morgensternR/Themometry_Enclosure/Thermometry_Enclosure/PCB_Assem.SLDASM

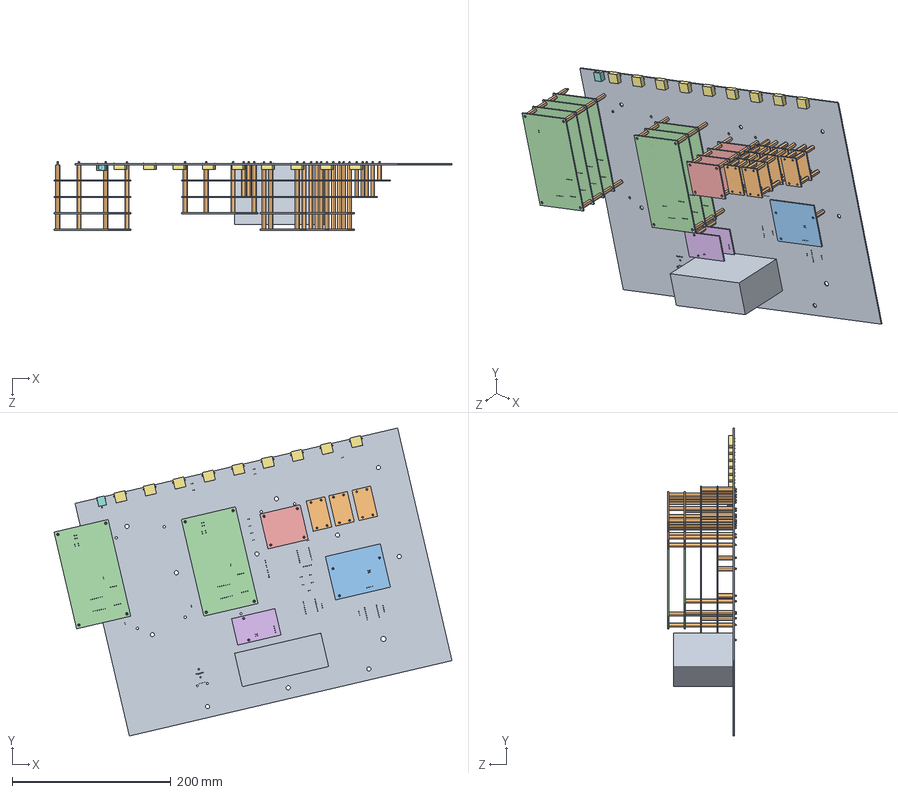
[picture p1: CAD file, 2025-06-28]
Thermometry_Enclosure/PCB_Assem.SLDASM
500.9 x 387.6 x 86.6 mm
Thermometry_Enclosure.step
Howland x 10
i2c_mux
sq_lockin_v6 x 7
hp_heater x 4
uart_mux x 2
hdmi_mockup x 9
DC_Power_Port
linux_pc
93505A215_Male-Female Threaded Hex Standoff x 91
