morgensternR/Themometry_Enclosure/Thermometry_Enclosure/Main.SLDASM

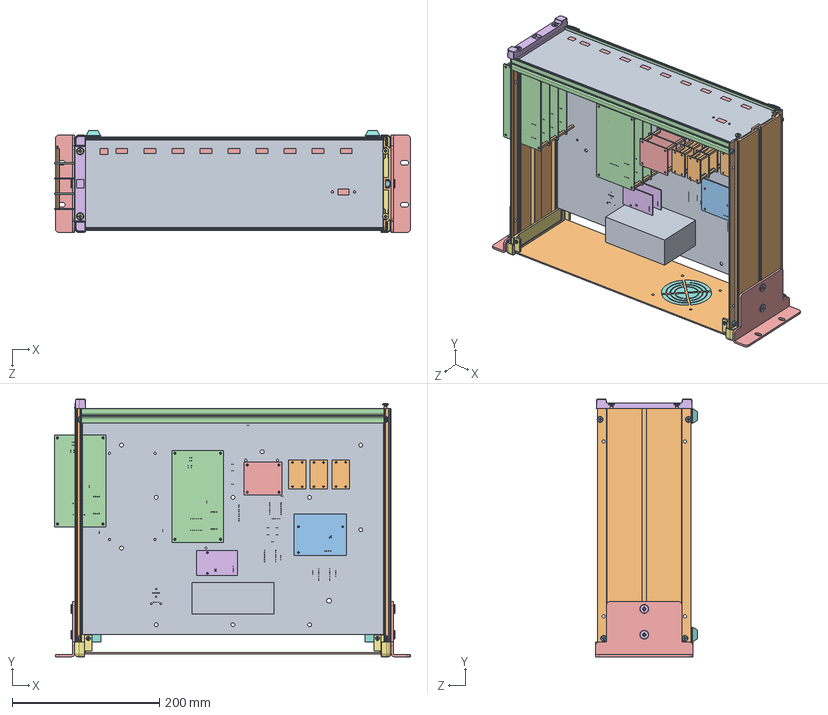
[picture p2: CAD file, 2023-06-21]
Thermometry_Enclosure/Main.SLDASM
483.8 x 350.0 x 138.6 mm
Thermometry_Enclosure.step
Howland x 10
i2c_mux
sq_lockin_v6 x 7
hp_heater x 4
uart_mux x 2
hdmi_mockup x 9
DC_Power_Port
linux_pc
93505A215_Male-Female Threaded Hex Standoff x 91
mz(ﾎﾙﾀﾞｰ).stp x 4
JIS B 1181 - A_B M5.stp x 4
msm-133_1.stp x 2
JIS B 1111 - M5x10.stp x 4
msk-133.stp x 2
JIS B 1111 (H) - M4x6 - CU2 - H.stp x 4
mss132.5-04.stp x 2
JIS B 1111 - A M4 x 8 - H.stp x 8
msf(rear)-06.stp x 2
JIS B 1111 - M4x10.stp x 4
ｺﾞﾑ足.stp x 4
Back_Panel
front_panel
