morgensternR/Themometry_Enclosure/Motherboard V2/back_panel.SLDPRT

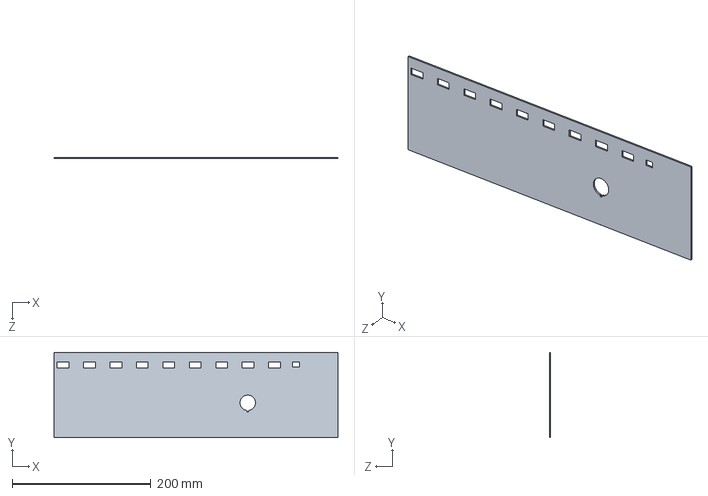
[picture p5: CAD file, 2025-06-28]
Motherboard V2/back_panel.SLDPRT
409.0 x 122.5 x 2.00 mm
