morgensternR/Themometry_Enclosure/Motherboard V2/Footprints & CAD/c-205869-1-ab-3d-50pin-Dsub.stp

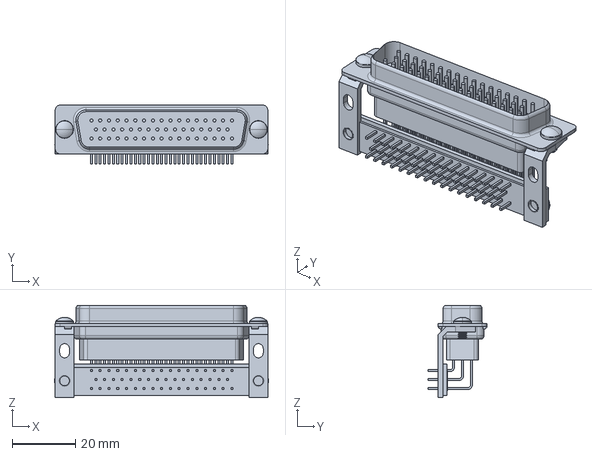
[picture p6: CAD file, 2025-04-04]
Motherboard V2/Footprints & CAD/c-205869-1-ab-3d-50pin-Dsub.stp
67.5 x 18.6 x 29.1 mm
