morgensternR/Themometry_Enclosure/Motherboard V2/Footprints & CAD/CAD/DC-IN-TH_DC-044K-D025.step

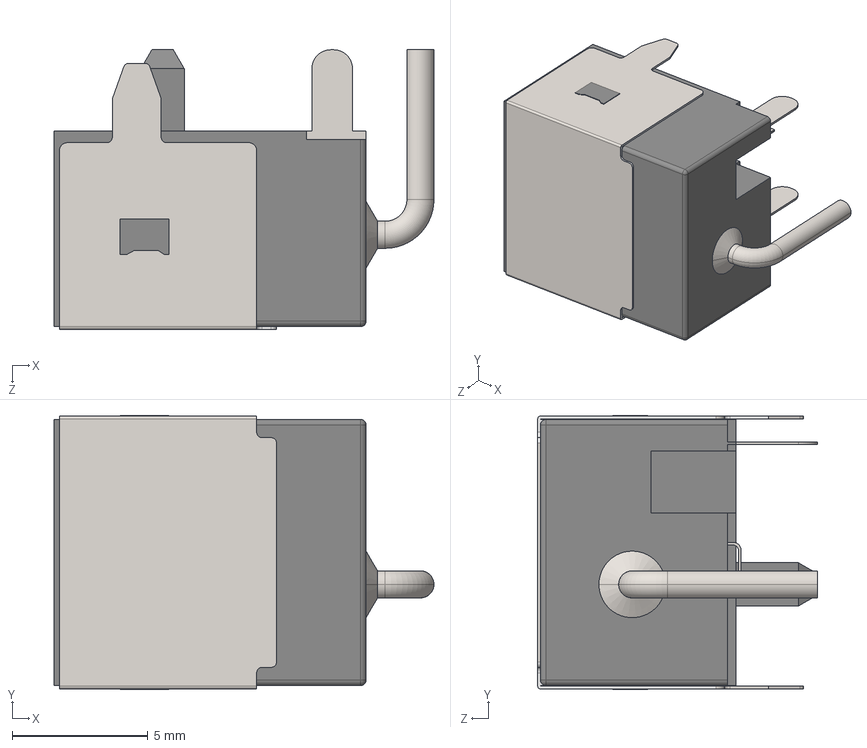
[picture p7: CAD file, 2025-05-05]
Motherboard V2/Footprints & CAD/CAD/DC-IN-TH_DC-044K-D025.step
14.0 x 10.1 x 10.3 mm
