morgensternR/Themometry_Enclosure/support_peg.SLDPRT

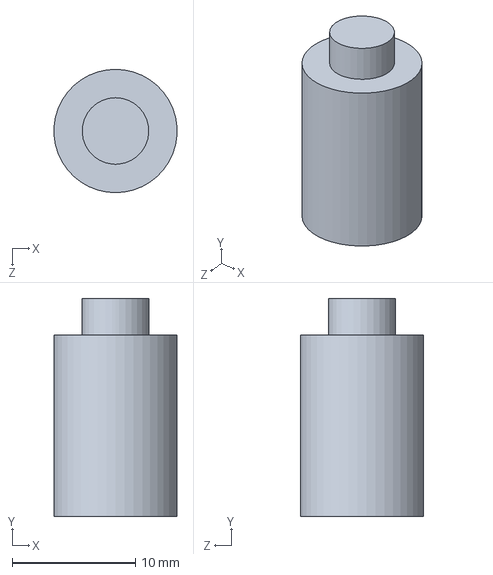
[picture p8: CAD file, 2023-06-21]
support_peg.SLDPRT
9.97 x 17.7 x 10.0 mm
