morgensternR/Themometry_Enclosure/Motherboard V2/Footprints & CAD/CAD/HDMI_RG9922-111D20-01B0.stp

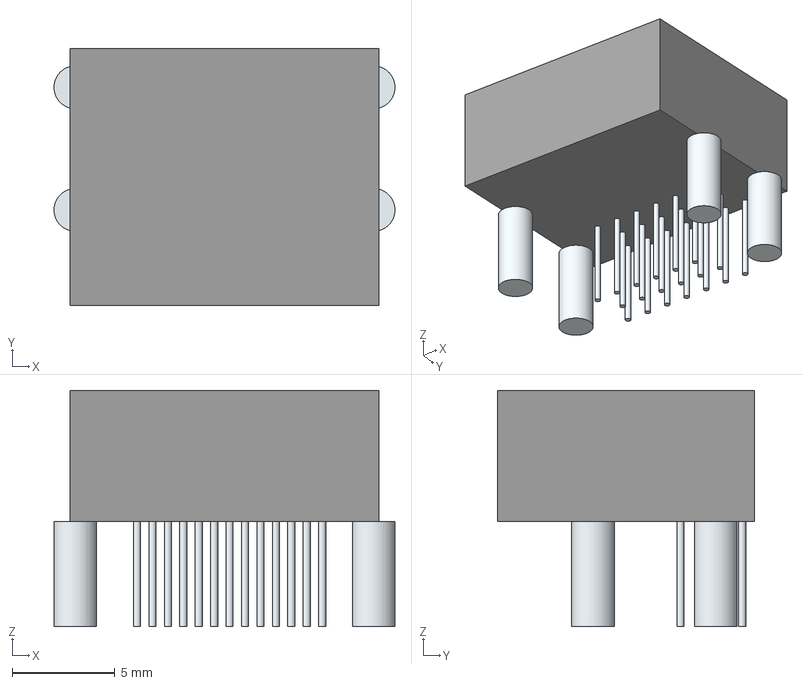
[picture p9: CAD file, 2025-05-05]
Motherboard V2/Footprints & CAD/CAD/HDMI_RG9922-111D20-01B0.stp
16.6 x 12.5 x 11.5 mm
Leads
