morgensternR/Themometry_Enclosure/Motherboard V2/support_peg.SLDPRT

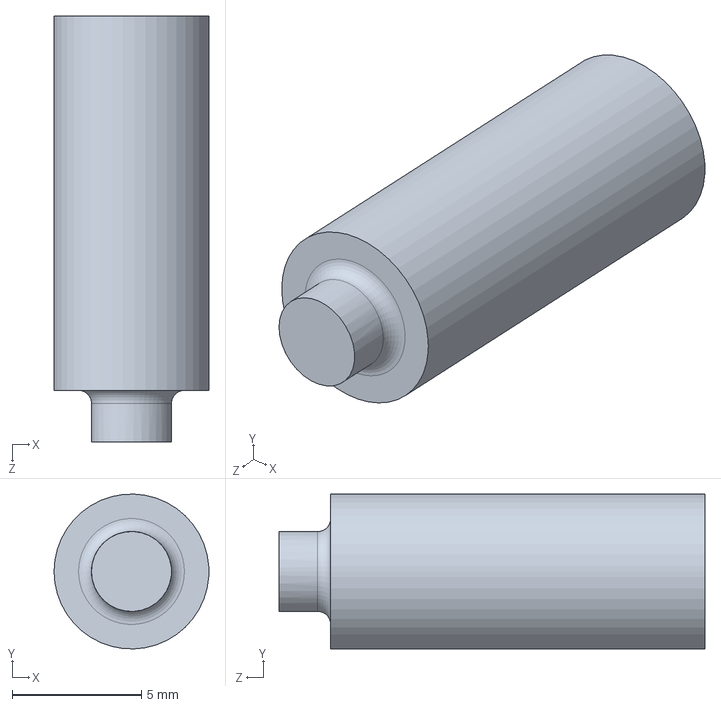
[picture p10: CAD file, 2025-06-28]
Motherboard V2/support_peg.SLDPRT
6.00 x 6.00 x 16.5 mm
