morgensternR/Themometry_Enclosure/Motherboard V2/Footprints & CAD/CAD/CONN-TH_436500215.step

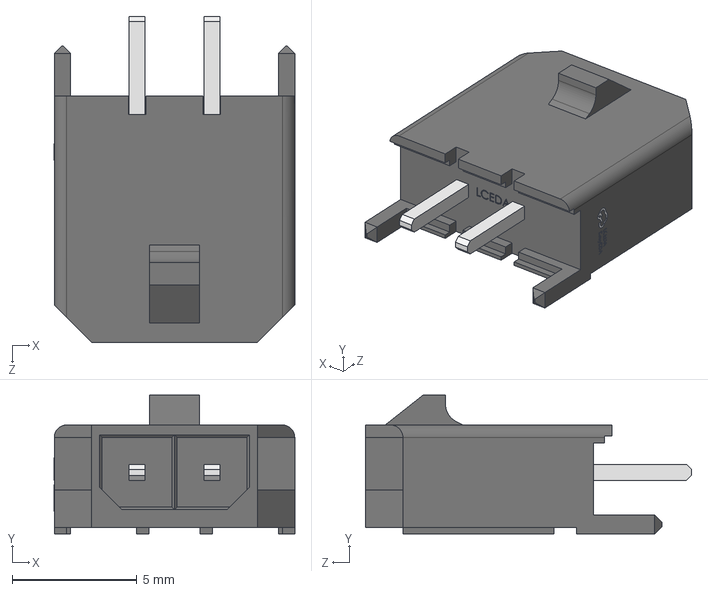
[picture p11: CAD file, 2025-04-04]
Motherboard V2/Footprints & CAD/CAD/CONN-TH_436500215.step
9.65 x 5.57 x 13.1 mm
