morgensternR/Themometry_Enclosure/Motherboard V2/motherboard_v1.step

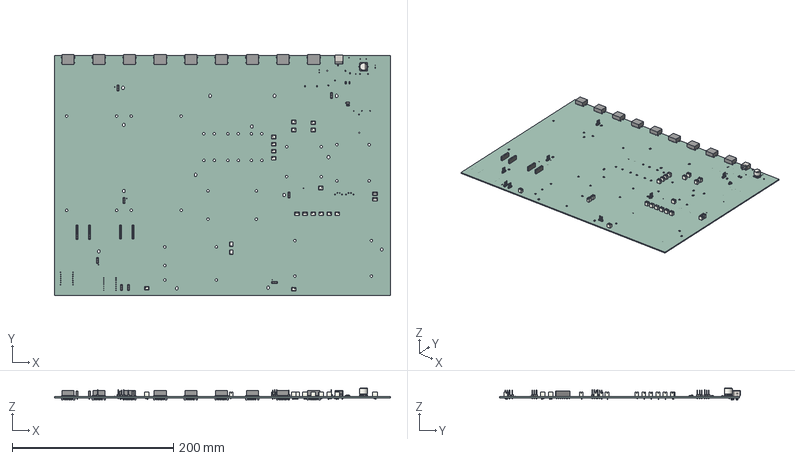
[picture p12: CAD file, 2025-06-28]
Motherboard V2/motherboard_v1.step
417.0 x 299.6 x 14.5 mm
C_1206_3216Metric x 3
R_0402_1005Metric x 3
ASSEMBLY x 9
JST_B2B_PH_K x 21
C_0402_1005Metric x 6
PinSocket_1x07_P254mm_Vertical x 4
PinHeader_1x03_P254mm_Vertical x 8
DC-IN-TH_DC-044K-D025
D_SMA
C_0603_1608Metric x 2
LED_0603_1608Metric x 2
CP_Elec_10x105
motherboard_v1_PCB
