morgensternR/Themometry_Enclosure/Thermometry_Enclosure/hdmi_mockup.SLDPRT

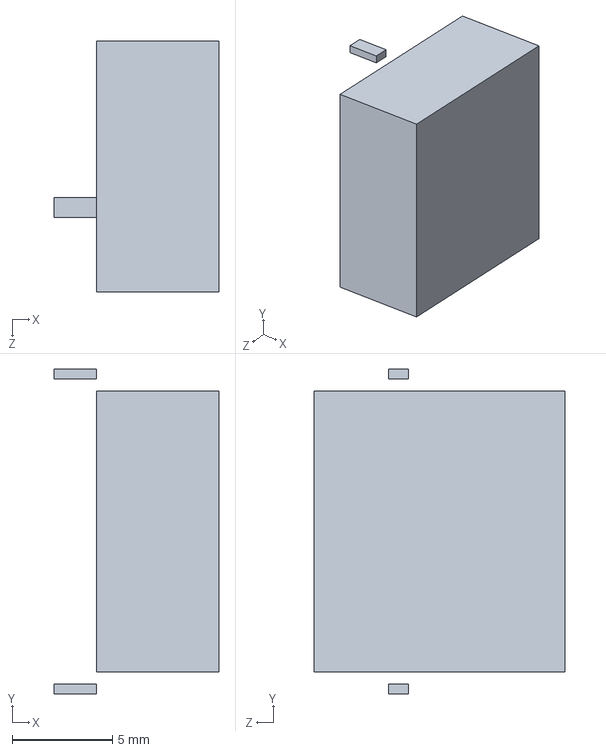
[picture p13: CAD file, 2025-06-28]
Thermometry_Enclosure/hdmi_mockup.SLDPRT
8.20 x 16.2 x 12.5 mm
