morgensternR/Themometry_Enclosure/Motherboard V2/Footprints & CAD/CAD/FUSE-SMD_L6.1-W2.7-H2.7.step

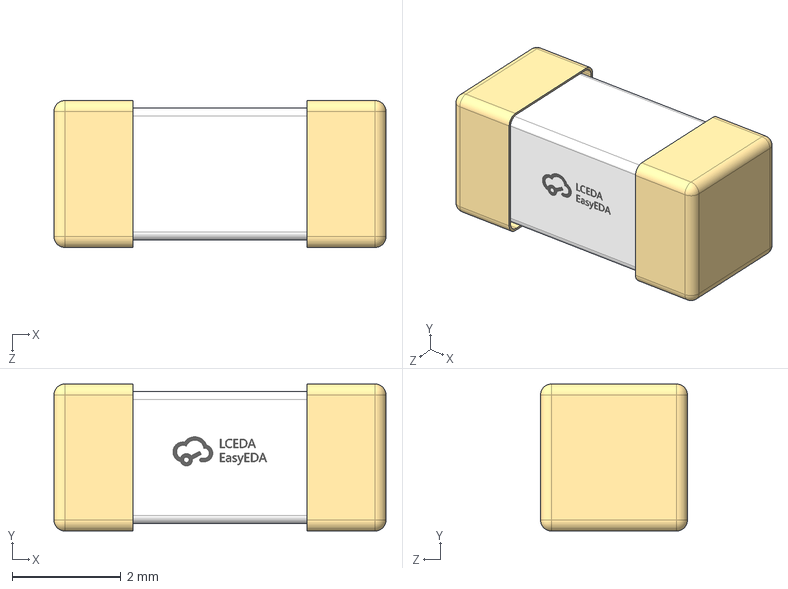
[picture p14: CAD file, 2025-04-04]
Motherboard V2/Footprints & CAD/CAD/FUSE-SMD_L6.1-W2.7-H2.7.step
6.10 x 2.70 x 2.70 mm
