morgensternR/Themometry_Enclosure/Thermometry_Enclosure/DC_Power_Port.SLDPRT

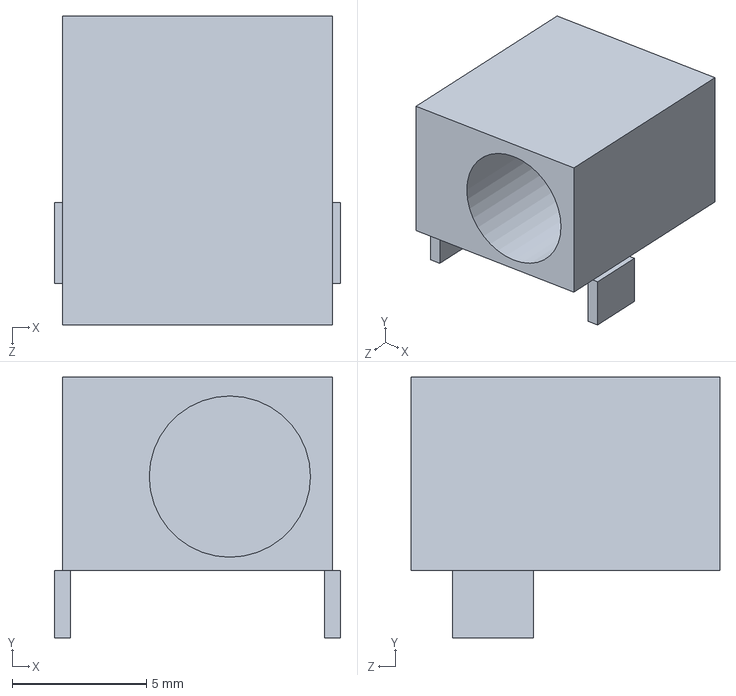
[picture p15: CAD file, 2025-06-28]
Thermometry_Enclosure/DC_Power_Port.SLDPRT
10.6 x 9.70 x 11.5 mm
