morgensternR/Themometry_Enclosure/Motherboard V2/Footprints & CAD/CAD/i2c_mux.step

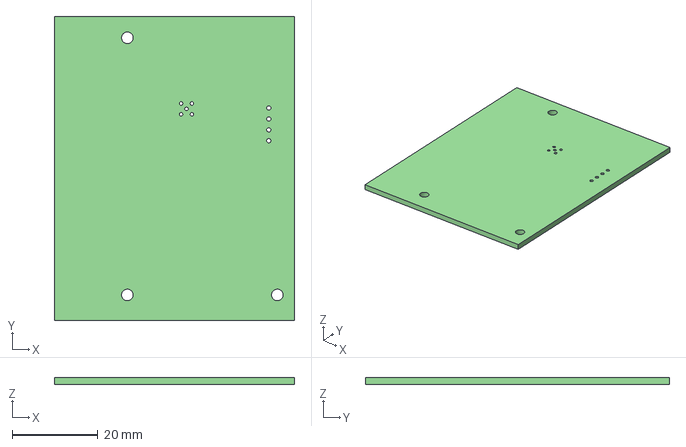
[picture p16: CAD file, 2025-04-04]
Motherboard V2/Footprints & CAD/CAD/i2c_mux.step
56.0 x 71.0 x 1.60 mm
