morgensternR/Themometry_Enclosure/Motherboard V2/input_power_connector_436500427.stp

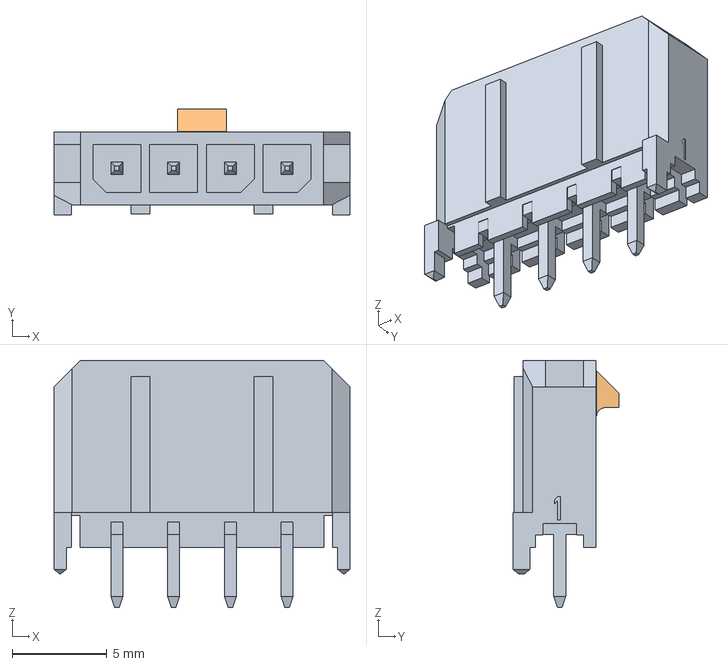
[picture p17: CAD file, 2025-04-04]
Motherboard V2/input_power_connector_436500427.stp
15.7 x 5.61 x 13.1 mm
