morgensternR/Themometry_Enclosure/Motherboard V2/BM04B-SRSS-TB.STEP

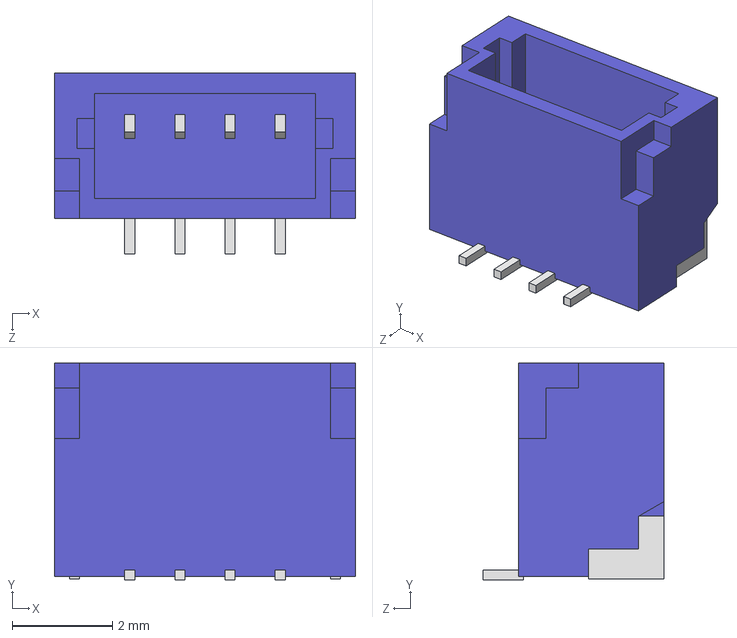
[picture p18: CAD file, 2025-04-04]
Motherboard V2/BM04B-SRSS-TB.STEP
6.00 x 4.32 x 3.60 mm
