morgensternR/Themometry_Enclosure/Thermometry_Enclosure/sq_lockin_v6.SLDPRT

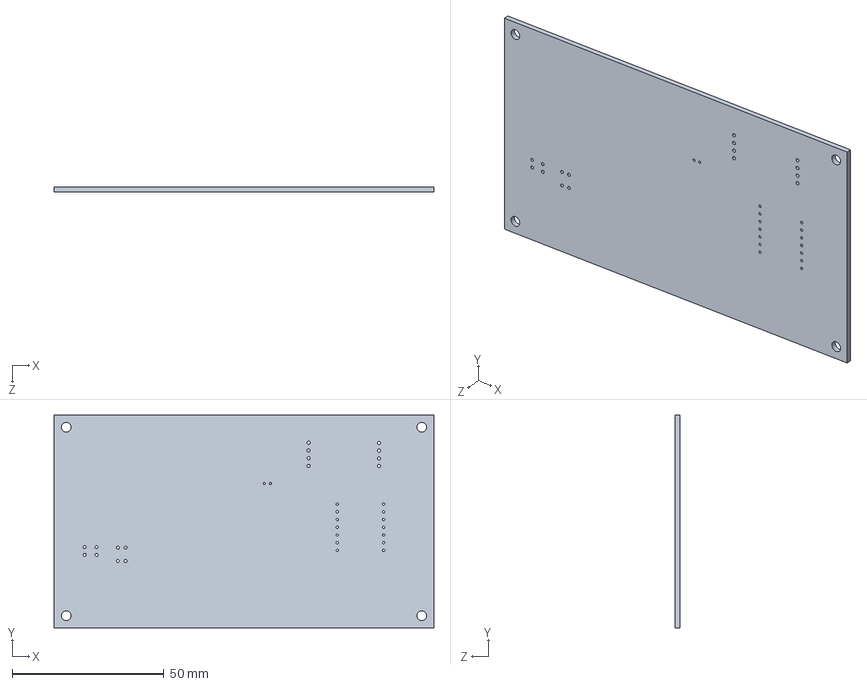
[picture p19: CAD file, 2025-06-28]
Thermometry_Enclosure/sq_lockin_v6.SLDPRT
125.0 x 70.0 x 1.60 mm
