morgensternR/Themometry_Enclosure/Thermometry_Enclosure/uart_mux.SLDPRT

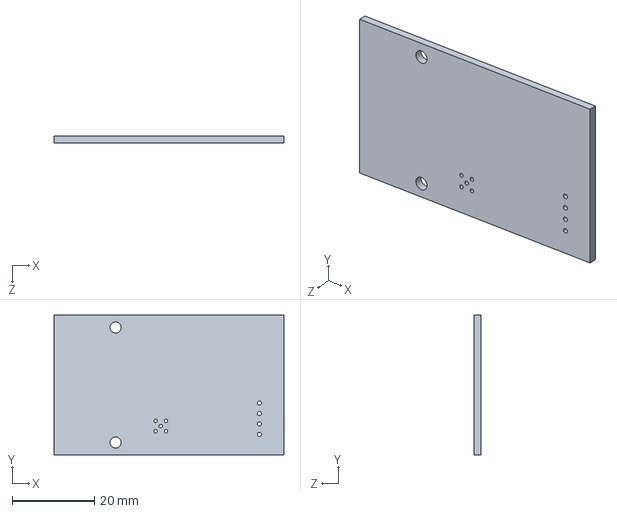
[picture p20: CAD file, 2025-06-28]
Thermometry_Enclosure/uart_mux.SLDPRT
56.0 x 34.0 x 1.60 mm
