morgensternR/Themometry_Enclosure/Thermometry_Enclosure/Thermometry_Enclosure.step.SLDPRT

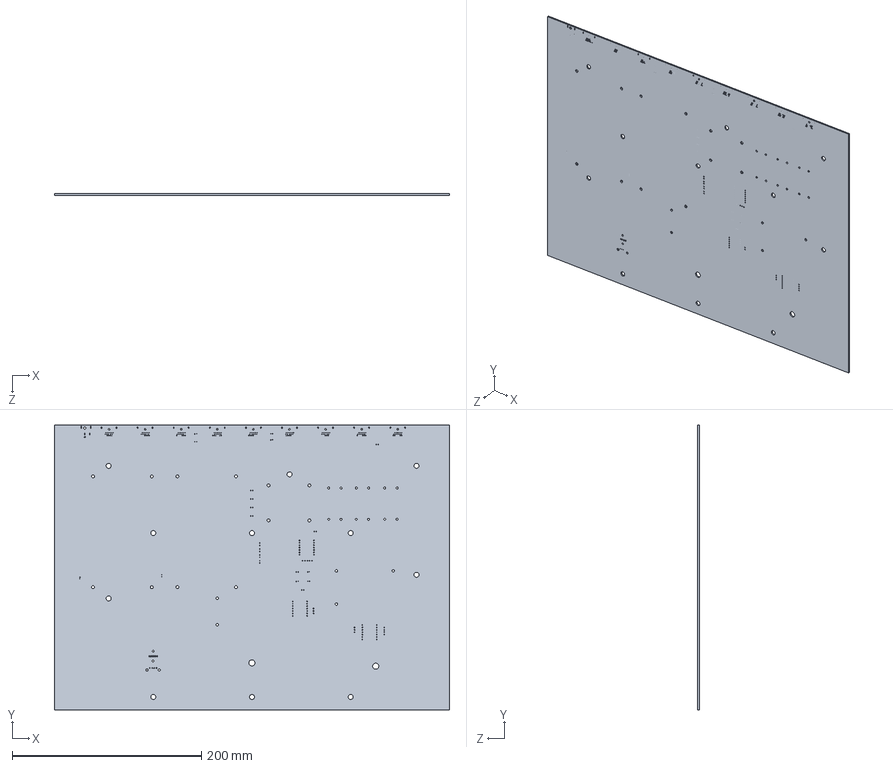
[picture p21: CAD file, 2025-06-28]
Thermometry_Enclosure/Thermometry_Enclosure.step.SLDPRT
417.0 x 300.6 x 1.60 mm
