morgensternR/Themometry_Enclosure/Thermometry_Enclosure/hp_heater.SLDPRT

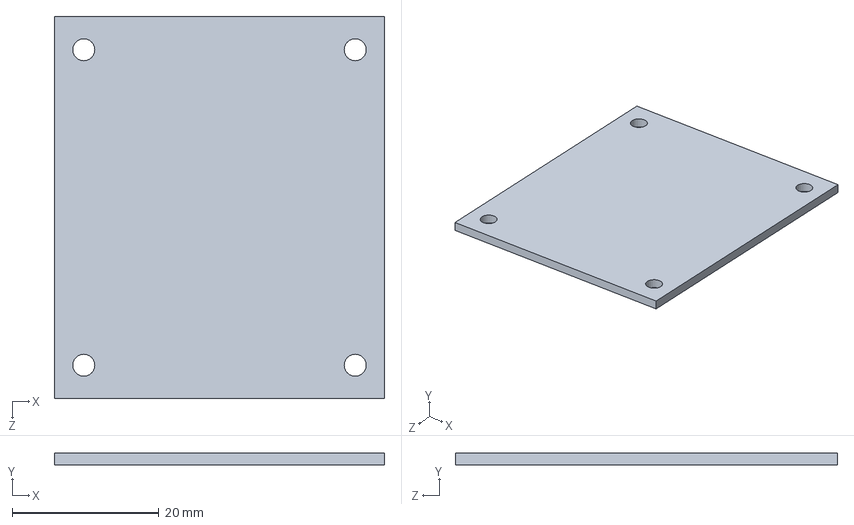
[picture p22: CAD file, 2025-06-28]
Thermometry_Enclosure/hp_heater.SLDPRT
45.0 x 1.60 x 52.1 mm
