morgensternR/Themometry_Enclosure/Thermometry_Enclosure/Howland.SLDPRT

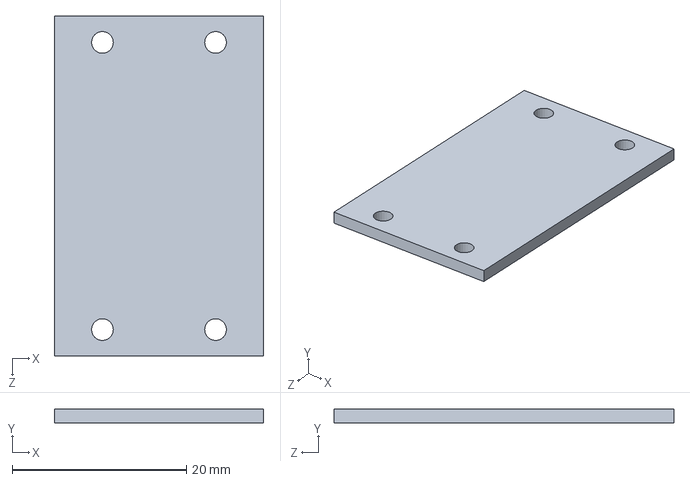
[picture p23: CAD file, 2025-06-28]
Thermometry_Enclosure/Howland.SLDPRT
24.0 x 1.60 x 39.1 mm
