morgensternR/Themometry_Enclosure/Thermometry_Enclosure/linux_pc.SLDPRT

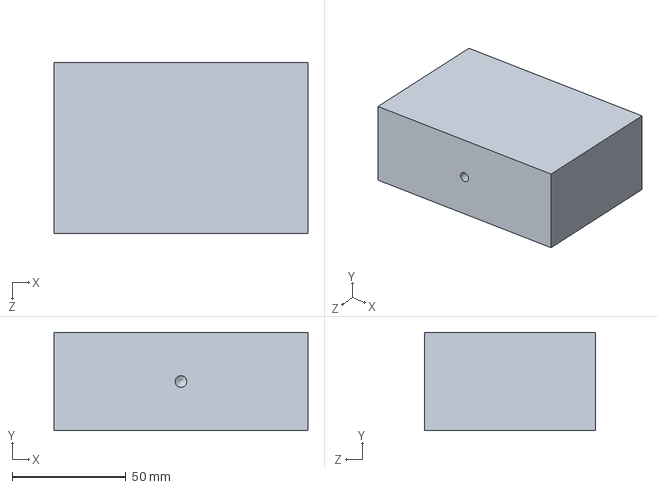
[picture p24: CAD file, 2025-06-28]
Thermometry_Enclosure/linux_pc.SLDPRT
111.5 x 43.2 x 75.0 mm
