morgensternR/Themometry_Enclosure/Motherboard V2/Main.SLDASM

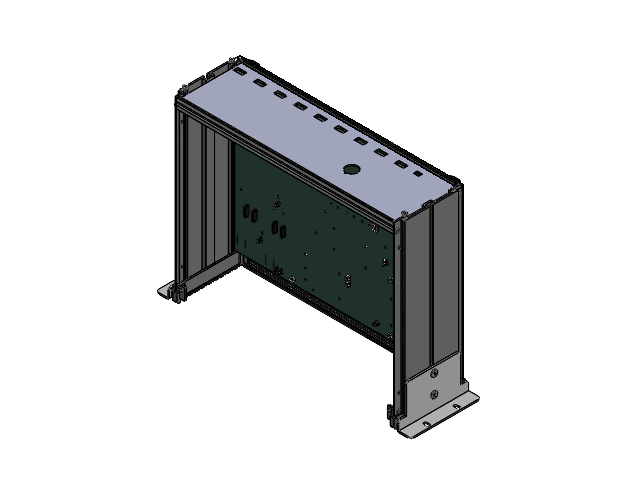
[picture p25: CAD file, 2025-06-28]
Motherboard V2/Main.SLDASM
mz(ﾎﾙﾀﾞｰ).stp x 4
JIS B 1181 - A_B M5.stp x 4
msm-133_1.stp x 2
JIS B 1111 - M5x10.stp x 4
msff-06.stp
msk-133.stp x 2
JIS B 1111 (H) - M4x6 - CU2 - H.stp x 4
mss132.5-04.stp x 2
JIS B 1111 - A M4 x 8 - H.stp x 8
msf(rear)-06.stp x 2
mot-21.stp
JIS B 1111 - M4x10.stp x 3
ｺﾞﾑ足.stp x 4
C_1206_3216Metric-0.step x 3
R_0402_1005Metric-1.step x 3
ASSEMBLY.step x 9
JST_B2B_PH_K.step x 21
C_0402_1005Metric-2.step x 6
PinSocket_1x07_P254mm_Vertical.step x 4
PinHeader_1x03_P254mm_Vertical.step x 8
DC-IN-TH_DC-044K-D025-3.step
D_SMA-4.step
C_0603_1608Metric-5.step x 2
LED_0603_1608Metric-6.step x 2
CP_Elec_10x105.step
motherboard_v1_PCB.step
front_panel
