morgensternR/Themometry_Enclosure/(list of files, cad)

Other CAD files:
Thermometry_Enclosure/front_panel.SLDPRT
Thermometry_Enclosure/Parts/MOR133-43-35□.stp
Thermometry_Enclosure/Back_Panel.SLDPRT
Thermometry_Enclosure/i2c_mux.SLDPRT
Thermometry_Enclosure/Thermometry_Enclosure.step
Thermometry_Enclosure/Back_Panel.DXF
Thermometry_Enclosure/Parts/93505A105_Male-Female Threaded Hex Standoff.SLDPRT
Thermometry_Enclosure/Parts/93505A215_Male-Female Threaded Hex Standoff.SLDPRT
Thermometry_Enclosure/front_panel.DXF
support_peg.STL
