morgensternR/Themometry_Enclosure/Motherboard V2/motherboard_v1.kicad_pcb

## KiCad design Motherboard V2/motherboard_v1.kicad_pcb (2025-04-04)

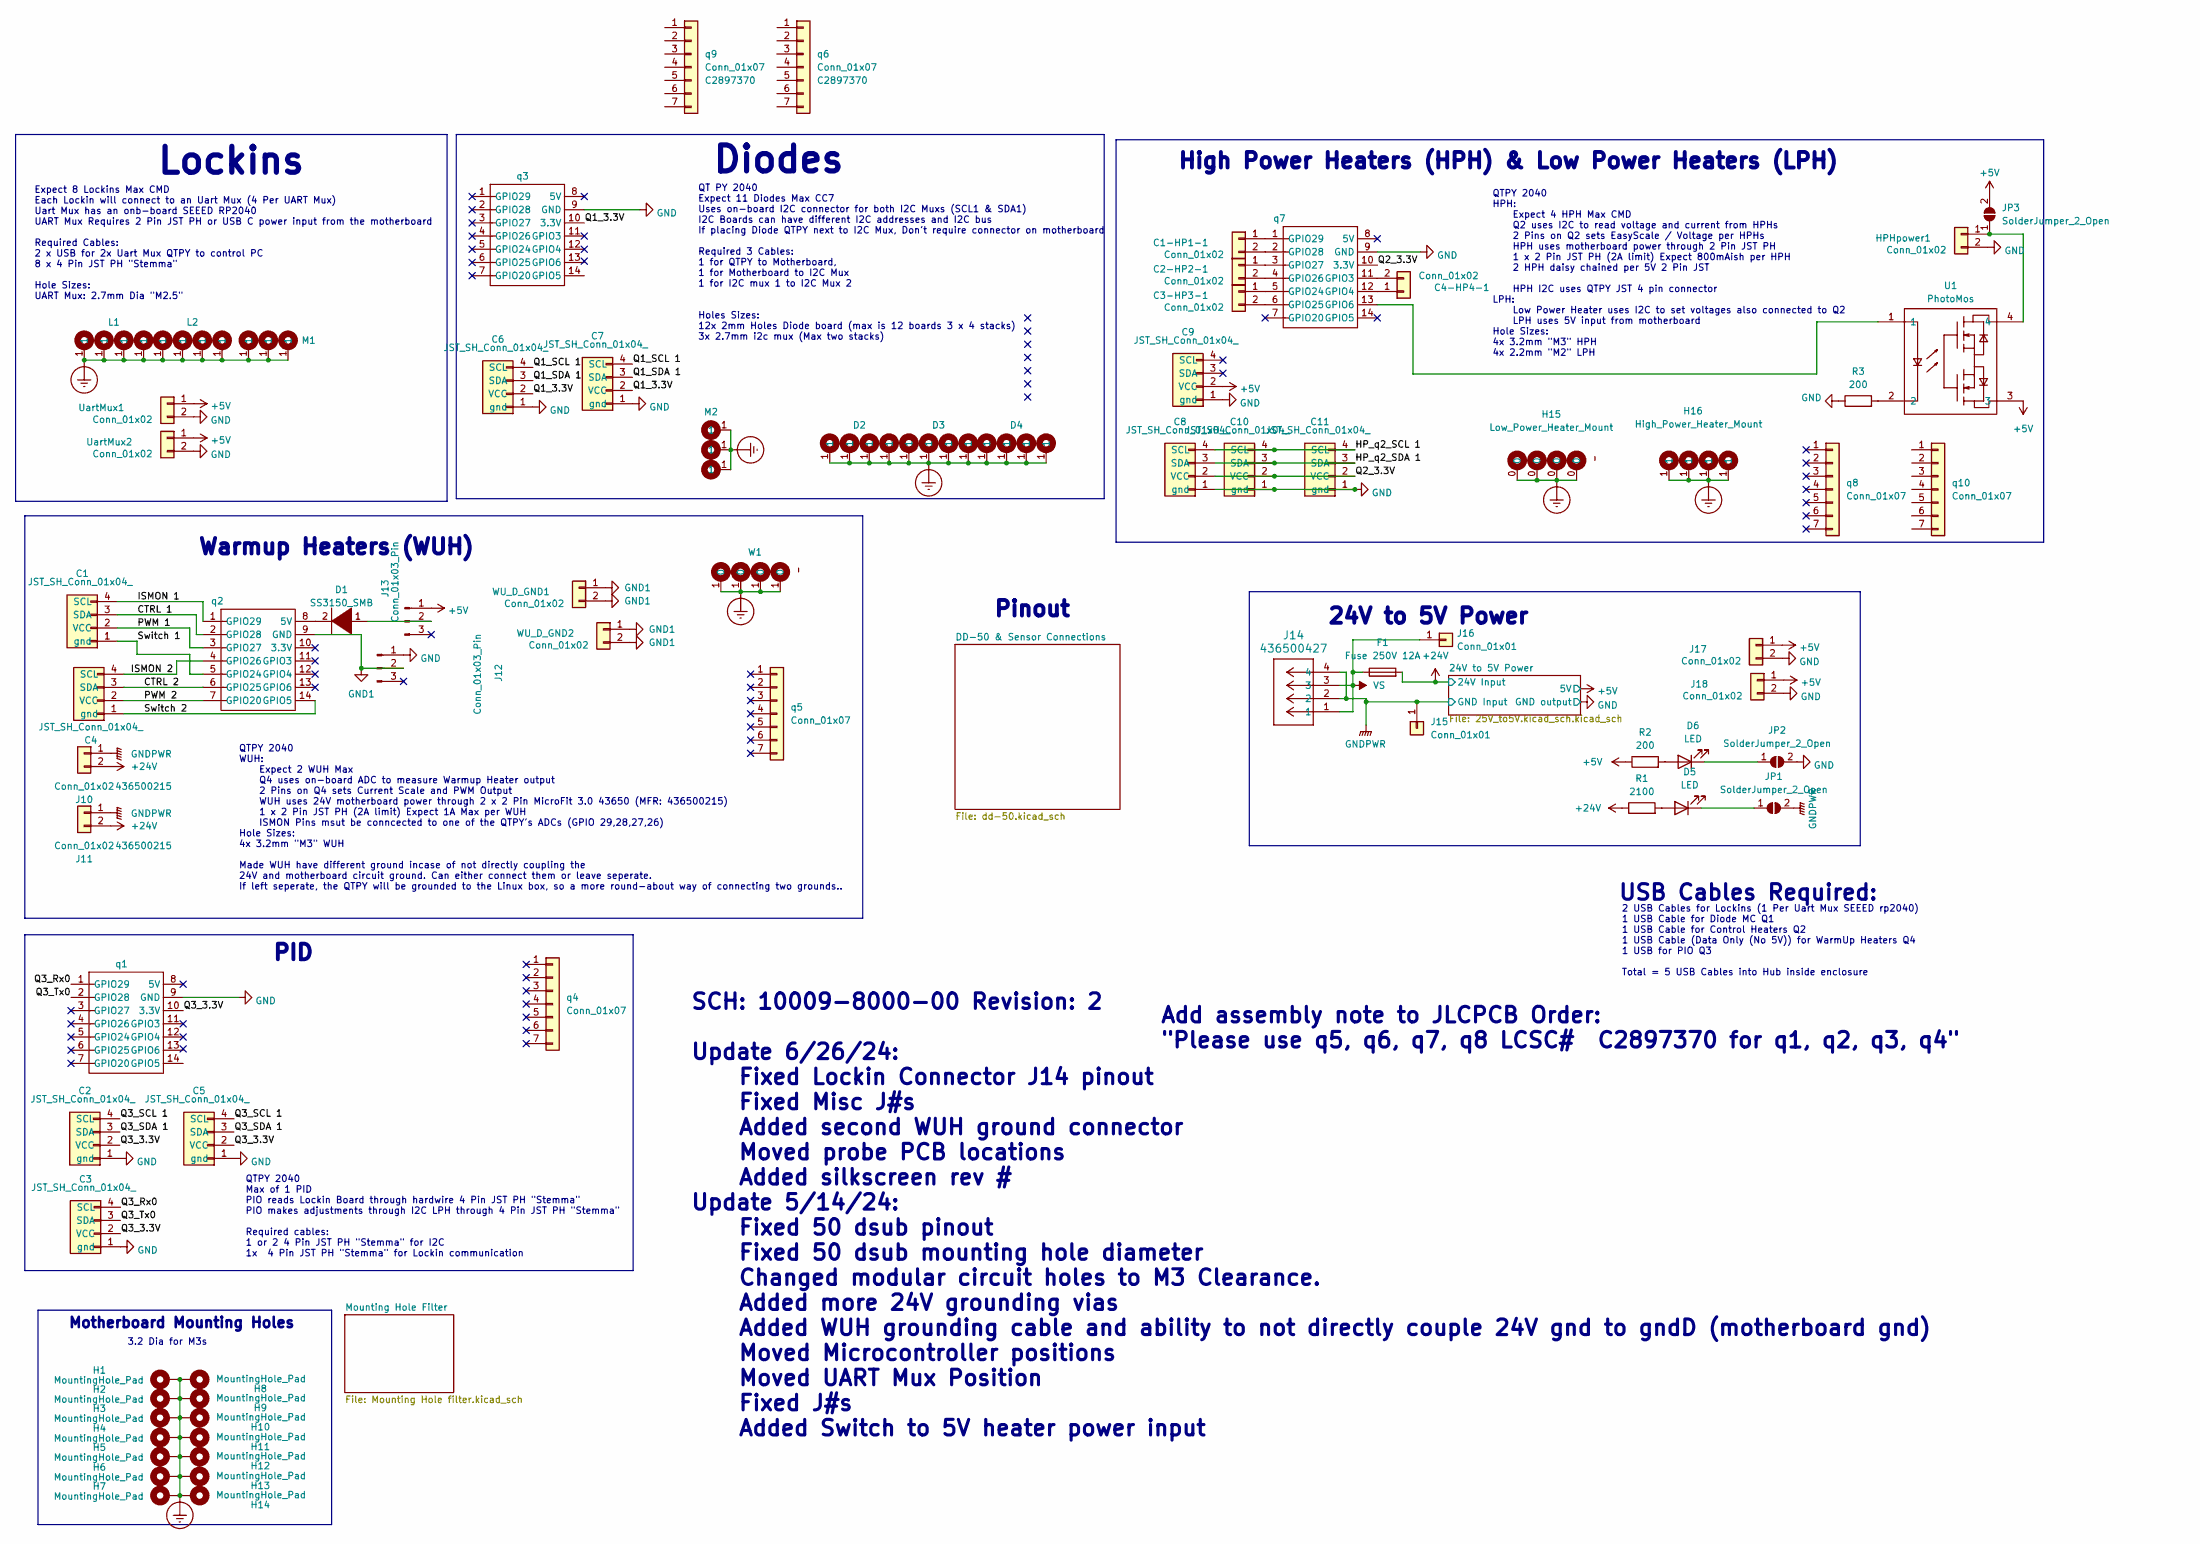
[picture p26: schematic motherboard_v1.kicad_sch]

Parts:
C1, C2, C3, C4, C5, C6, C7, C8, C9, C10, C11: JST_SH_Conn_01x04_; JST_SH_BM04B-SRSS-TB_1x04-1MP_P1.00mm_Vertical; MPN A1001WR-S; LCSC C160390
C1-HP1-1, C2-HP2-1, C3-HP3-1, C4-HP4-1: Conn_01x02; JST_PH_B2B-PH-K_1x02_P2.00mm_Vertical; LCSC C2683610
D1: SS3150_SMB; SMB_L4.6-W3.6-LS5.3-RD; LCSC C47124
D2, D3, D4: Diode_Board
D5, D6: LED; LED_0603_1608Metric_Pad1.05x0.95mm_HandSolder; LCSC C965804
F1: Fuse 250V 12A; Fuse_holder; LCSC C268204
H1, H2, H3, H4, H5, H6, H7, H8, H9, H10, H11, H12, H13, H14: MountingHole_Pad; Slot_Mounting_Hole
H15: Low_Power_Heater_Mount; Low_Power_Heater_Board
H16: High_Power_Heater_Mount; HPH_Board
HPHpower1: Conn_01x02; JST_PH_B2B-PH-K_1x02_P2.00mm_Vertical; LCSC C2683610
J10, J11: Conn_01x02; CONN-TH_436500215; LCSC C293740
J12, J13: Conn_01x03_Pin; PinHeader_1x03_P2.54mm_Vertical; LCSC C2937625
J14: 436500427; CON_436500427_MOL
J15: Conn_01x01; Test_Point_TH_BD3.2-D2.0; LCSC C5199811
J16: Conn_01x01; Test_Point_TH_BD3.2-D2.0; LCSC C5277086
J17, J18: Conn_01x02; JST_PH_B2B-PH-K_1x02_P2.00mm_Vertical; LCSC C2683610
JP1, JP2, JP3: SolderJumper_2_Open; SolderJumper-2_P1.3mm_Open_RoundedPad1.0x1.5mm
L1, L2: Lockin_board
M1: Uart Mux
M2: i2c_Mux
R1: 2100; R_0402_1005Metric; LCSC C2998067
R2, R3: 200; R_0402_1005Metric; LCSC C25087
U1: PhotoMos; HPH_Switch_SOP-4_L4.4-W4.3-P2.54-LS6.8-BL; LCSC C2691608
UartMux1, UartMux2: Conn_01x02; JST_PH_B2B-PH-K_1x02_P2.00mm_Vertical; LCSC C2683610
W1: Warmup circuit
WU_D_GND1, WU_D_GND2: Conn_01x02; JST_PH_B2B-PH-K_1x02_P2.00mm_Vertical; LCSC C2683610
q1, q2, q3, q7: Microcontroller-qtpy; LCSC C2897370
q4, q5, q6, q8, q9, q10: Conn_01x07; PinSocket_1x07_P2.54mm_Vertical; LCSC C2897370

Connections:
+5V: C9.2 (VCC), J13.1, J17.1, J18.1, JP3.2 (B), R2.1, U1.3, UartMux1.1, UartMux2.1; also elsewhere on the board
+24V: F1.2, J10.2, J11.2, R1.1; also elsewhere on the board
/CTRL 1: C1.3 (SDA), q2.2 (GPIO28)
/CTRL 2: C4.3 (SDA), q2.6 (GPIO25)
/HP_q2_SCL 1: C8.4 (SCL), C10.4 (SCL), C11.4 (SCL)
/HP_q2_SDA 1: C8.3 (SDA), C10.3 (SDA), C11.3 (SDA)
/ISMON 1: C1.4 (SCL), q2.1 (GPIO29)
/ISMON 2: C4.4 (SCL), q2.4 (GPIO26)
/PWM 1: C1.2 (VCC), q2.3 (GPIO27)
/PWM 2: C4.2 (VCC), q2.7 (GPIO20)
/Q1_3.3V: C6.2 (VCC), C7.2 (VCC), q3.10 (3.3V)
/Q1_SCL 1: C6.4 (SCL), C7.4 (SCL)
/Q1_SDA 1: C6.3 (SDA), C7.3 (SDA)
/Q2_3.3V: C8.2 (VCC), C10.2 (VCC), C11.2 (VCC), q7.10 (3.3V)
/Q3_3.3V: C2.2 (VCC), C3.2 (VCC), C5.2 (VCC), q1.10 (3.3V)
/Q3_Rx0: C3.4 (SCL), q1.1 (GPIO29)
/Q3_SCL 1: C2.4 (SCL), C5.4 (SCL)
/Q3_SDA 1: C2.3 (SDA), C5.3 (SDA)
/Q3_Tx0: C3.3 (SDA), q1.2 (GPIO28)
/Switch 1: C1.1 (gnd), q2.5 (GPIO24)
/Switch 2: C4.1 (gnd), q2.14 (GPIO5)
Earth_Protective: D2.1, D3.1, D4.1, H1.1, H2.1, H3.1, H4.1, H5.1, H6.1, H7.1, H8.1, H9.1, H10.1, H11.1, H12.1, H13.1, H14.1, H15.0, H16.1, L1.1, L2.1, M1.1, M2.1, W1.1 (0); also elsewhere on the board
GND: C2.1 (gnd), C3.1 (gnd), C5.1 (gnd), C6.1 (gnd), C7.1 (gnd), C8.1 (gnd), C9.1 (gnd), C10.1 (gnd), C11.1 (gnd), HPHpower1.2, J12.1, J17.2, J18.2, JP2.2 (B), R3.1, UartMux1.2, UartMux2.2, q1.9 (GND), q3.9 (GND), q7.9 (GND); also elsewhere on the board
GND1: J12.2, WU_D_GND1.1, WU_D_GND1.2, WU_D_GND2.1, WU_D_GND2.2, q2.9 (GND)
GNDPWR: J10.1, J11.1, J14.2, J14.4, J15.1, JP1.2 (B); also elsewhere on the board
unnamed: C1-HP1-1.1, q7.1 (GPIO29)
unnamed: C1-HP1-1.2, q7.2 (GPIO28)
unnamed: C2-HP2-1.1, q7.3 (GPIO27)
unnamed: C2-HP2-1.2, q7.4 (GPIO26)
unnamed: C3-HP3-1.1, q7.5 (GPIO24)
unnamed: C3-HP3-1.2, q7.6 (GPIO25)
unnamed: C4-HP4-1.1, q7.12 (GPIO4)
unnamed: C4-HP4-1.2, q7.11 (GPIO3)
unnamed: D1.2 (A), q2.8 (5V)
unnamed: D1.1 (K), J13.2
unnamed: D5.2 (A), R1.2
unnamed: D5.1 (K), JP1.1 (A)
unnamed: D6.2 (A), R2.2
unnamed: D6.1 (K), JP2.1 (A)
unnamed: HPHpower1.1, JP3.1 (A), U1.4
unnamed: R3.2, U1.2
unnamed: U1.1, q7.13 (GPIO6)
VS: F1.1, J14.1, J14.3, J16.1

Notes on the sheet:
High Power Heaters (HPH) & Low Power Heaters (LPH)
24V to 5V Power
QT PY 2040 Expect 11 Diodes Max CC7 Uses on-board I2C connector for both I2C Muxs (SCL1 & SDA1) I2C Boards can have different I2C addresses and I2C bus If placing Diode QTPY next to I2C Mux, Don't require connector on motherboard Required 3 Cables: 1 for QTPY to Motherboard, 1 for Motherboard to I2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
Diodes
Lockins
Expect 8 Lockins Max CMD Each Lockin will connect to an Uart Mux (4 Per UART Mux) Uart Mux has an onb-board SEEED RP2040 UART Mux Requires 2 Pin JST PH or USB C power input from the motherboard Required Cables: 2 x USB for 2x Uart Mux QTPY to control PC 8 x 4 Pin JST PH "Stemma" Hole Sizes: UART Mu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
Warmup Heaters (WUH)
QTPY 2040 HPH: Expect 4 HPH Max CMD Q2 uses I2C to read voltage and current from HPHs 2 Pins on Q2 sets EasyScale / Voltage per HPHs HPH uses motherboard power through 2 Pin JST PH 1 x 2 Pin JST PH (2A limit) Expect 800mAish per HPH 2 HPH daisy chained per 5V 2 Pin JST HPH I2C uses QTPY JST 4 pin c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
Pinout
PID
QTPY 2040 Max of 1 PID PIO reads Lockin Board through hardwire 4 Pin JST PH "Stemma" PIO makes adjustments through I2C LPH through 4 Pin JST PH "Stemma" Required cables: 1 or 2 4 Pin JST PH "Stemma" for I2C 1x 4 Pin JST PH "Stemma" for Lockin communication
USB Cables Required:
Motherboard Mounting Holes
Add assembly note to JLCPCB Order: "Please use q5, q6, q7, q8 LCSC# C2897370 for q1, q2, q3, q4"
SCH: 10009-8000-00 Revision: 2 Update 6/26/24: Fixed Lockin Connector J14 pinout Fixed Misc J#s Added second WUH ground connector Moved probe PCB locations Added silkscreen rev # Update 5/14/24: Fixed 50 dsub pinout Fixed 50 dsub mounting hole diameter Changed modular circuit holes to M3 Clearance.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
QTPY 2040 WUH: Expect 2 WUH Max Q4 uses on-board ADC to measure Warmup Heater output 2 Pins on Q4 sets Current Scale and PWM Output WUH uses 24V motherboard power through 2 x 2 Pin MicroFit 3.0 43650 (MFR: 436500215) 1 x 2 Pin JST PH (2A limit) Expect 1A Max per WUH ISMON Pins msut be conncected to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
3.2 Dia for M3s
2 USB Cables for Lockins (1 Per Uart Mux SEEED rp2040) 1 USB Cable for Diode MC Q1 1 USB Cable for Control Heaters Q2 1 USB Cable (Data Only (No 5V)) for WarmUp Heaters Q4 1 USB for PIO Q3 Total = 5 USB Cables into Hub inside enclosure

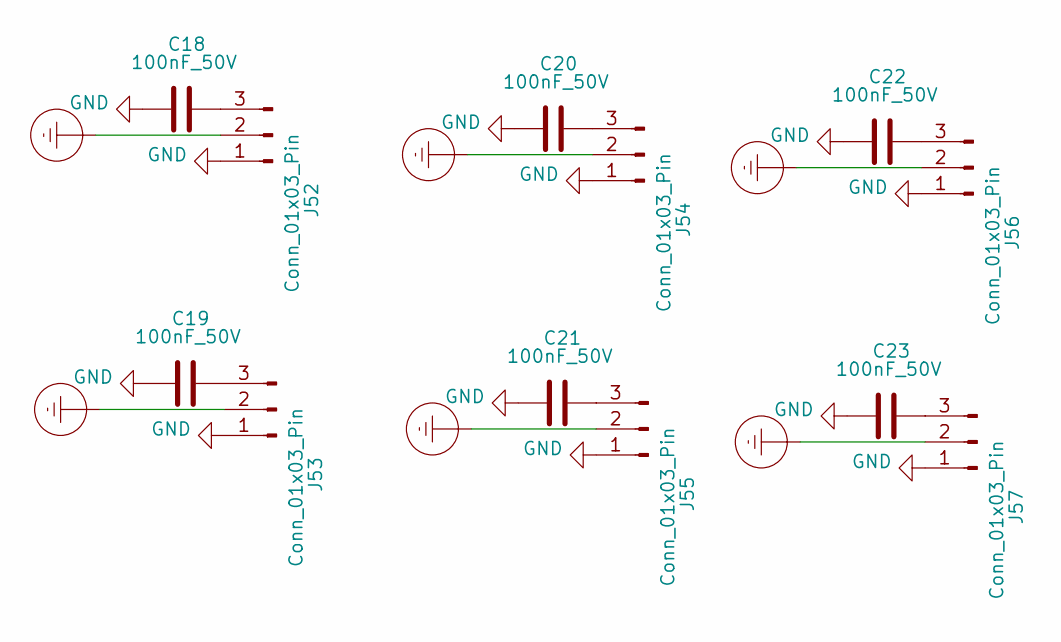
[picture p27: schematic Mounting Hole filter.kicad_sch]

Parts:
C18, C19, C20, C21, C22, C23: 100nF_50V; C_0402_1005Metric_Pad0.74x0.62mm_HandSolder; LCSC C307331
J52, J53, J54, J55, J56, J57: Conn_01x03_Pin; PinHeader_1x03_P2.54mm_Vertical; LCSC C2937625

Connections:
Earth_Protective: J52.2, J53.2, J54.2, J55.2, J56.2, J57.2; also elsewhere on the board
GND: C18.1, C19.1, C20.1, C21.1, C22.1, C23.1, J52.1, J53.1, J54.1, J55.1, J56.1, J57.1; also elsewhere on the board
unnamed: C18.2, J52.3
unnamed: C19.2, J53.3
unnamed: C20.2, J54.3
unnamed: C21.2, J55.3
unnamed: C22.2, J56.3
unnamed: C23.2, J57.3

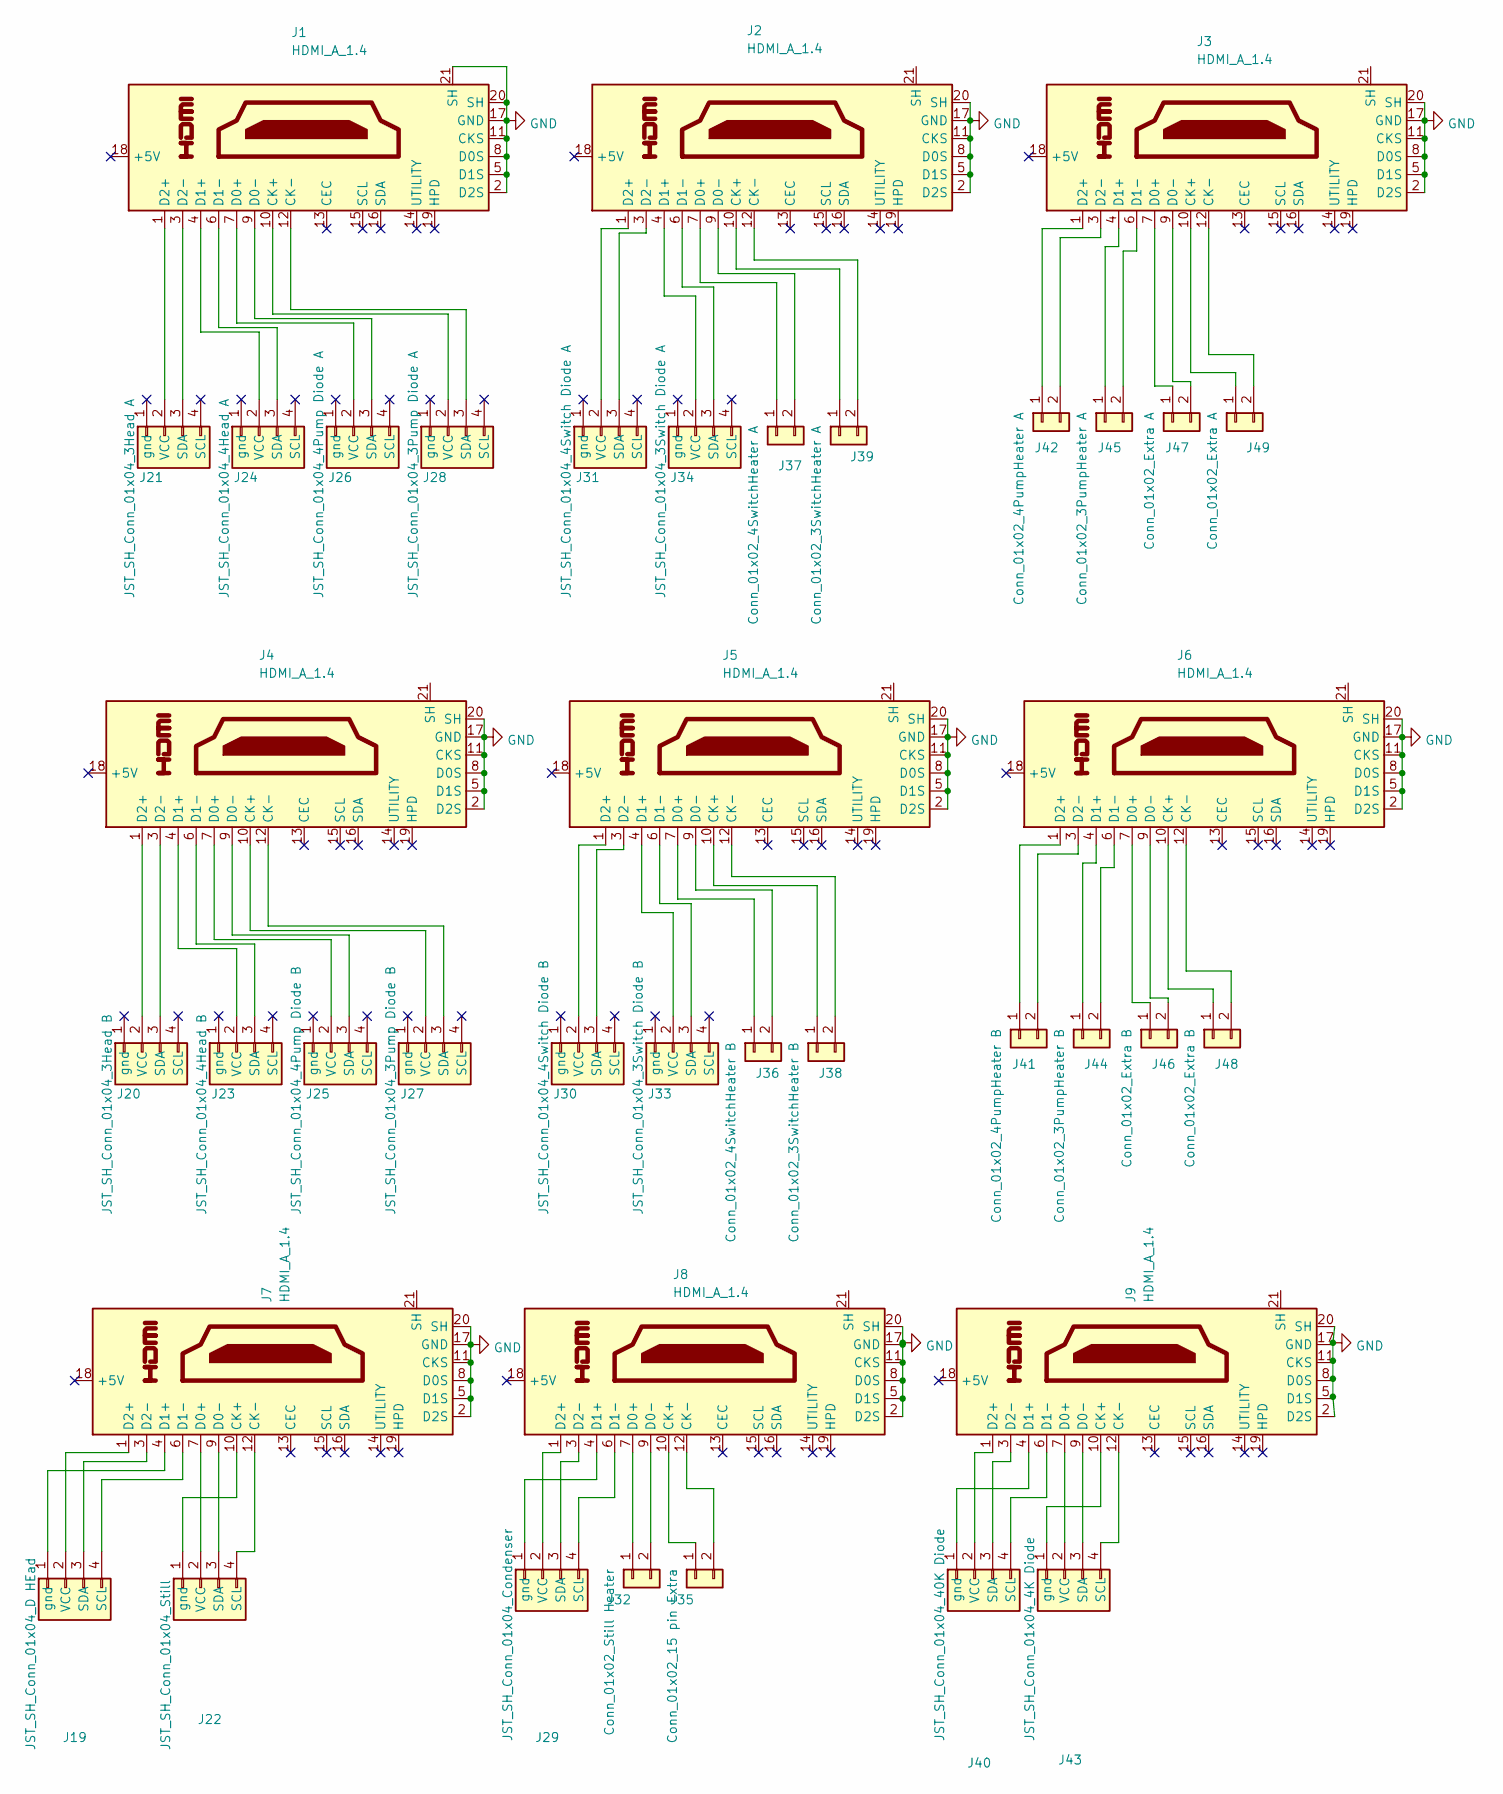
[picture p28: schematic dd-50.kicad_sch]

Parts:
J1, J2, J3, J4, J5, J6, J7, J8, J9: HDMI_A_1.4; HDMI-TH_D-HDMIM19P-FC00; LCSC C3025483
J19: JST_SH_Conn_01x04_D HEad; JST_SH_BM04B-SRSS-TB_1x04-1MP_P1.00mm_Vertical; MPN A1001WR-S; LCSC C160390
J20: JST_SH_Conn_01x04_3Head B; JST_SH_BM04B-SRSS-TB_1x04-1MP_P1.00mm_Vertical; MPN A1001WR-S; LCSC C160390
J21: JST_SH_Conn_01x04_3Head A; JST_SH_BM04B-SRSS-TB_1x04-1MP_P1.00mm_Vertical; MPN A1001WR-S; LCSC C160390
J22: JST_SH_Conn_01x04_Still; JST_SH_BM04B-SRSS-TB_1x04-1MP_P1.00mm_Vertical; MPN A1001WR-S; LCSC C160390
J23: JST_SH_Conn_01x04_4Head B; JST_SH_BM04B-SRSS-TB_1x04-1MP_P1.00mm_Vertical; MPN A1001WR-S; LCSC C160390
J24: JST_SH_Conn_01x04_4Head A; JST_SH_BM04B-SRSS-TB_1x04-1MP_P1.00mm_Vertical; MPN A1001WR-S; LCSC C160390
J25: JST_SH_Conn_01x04_4Pump Diode B; JST_SH_BM04B-SRSS-TB_1x04-1MP_P1.00mm_Vertical; MPN A1001WR-S; LCSC C160390
J26: JST_SH_Conn_01x04_4Pump Diode A; JST_SH_BM04B-SRSS-TB_1x04-1MP_P1.00mm_Vertical; MPN A1001WR-S; LCSC C160390
J27: JST_SH_Conn_01x04_3Pump Diode B; JST_SH_BM04B-SRSS-TB_1x04-1MP_P1.00mm_Vertical; MPN A1001WR-S; LCSC C160390
J28: JST_SH_Conn_01x04_3Pump Diode A; JST_SH_BM04B-SRSS-TB_1x04-1MP_P1.00mm_Vertical; MPN A1001WR-S; LCSC C160390
J29: JST_SH_Conn_01x04_Condenser; JST_SH_BM04B-SRSS-TB_1x04-1MP_P1.00mm_Vertical; MPN A1001WR-S; LCSC C160390
J30: JST_SH_Conn_01x04_4Switch Diode B; JST_SH_BM04B-SRSS-TB_1x04-1MP_P1.00mm_Vertical; MPN A1001WR-S; LCSC C160390
J31: JST_SH_Conn_01x04_4Switch Diode A; JST_SH_BM04B-SRSS-TB_1x04-1MP_P1.00mm_Vertical; MPN A1001WR-S; LCSC C160390
J32: Conn_01x02_Still Heater; JST_PH_B2B-PH-K_1x02_P2.00mm_Vertical; LCSC C5175230
J33: JST_SH_Conn_01x04_3Switch Diode B; JST_SH_BM04B-SRSS-TB_1x04-1MP_P1.00mm_Vertical; MPN A1001WR-S; LCSC C160390
J34: JST_SH_Conn_01x04_3Switch Diode A; JST_SH_BM04B-SRSS-TB_1x04-1MP_P1.00mm_Vertical; MPN A1001WR-S; LCSC C160390
J35: Conn_01x02_15 pin Extra; JST_PH_B2B-PH-K_1x02_P2.00mm_Vertical; LCSC C5175230
J36: Conn_01x02_4SwitchHeater B; JST_PH_B2B-PH-K_1x02_P2.00mm_Vertical; LCSC C5175230
J37: Conn_01x02_4SwitchHeater A; JST_PH_B2B-PH-K_1x02_P2.00mm_Vertical; LCSC C5175230
J38: Conn_01x02_3SwitchHeater B; JST_PH_B2B-PH-K_1x02_P2.00mm_Vertical; LCSC C5175230
J39: Conn_01x02_3SwitchHeater A; JST_PH_B2B-PH-K_1x02_P2.00mm_Vertical; LCSC C5175230
J40: JST_SH_Conn_01x04_40K Diode; JST_SH_BM04B-SRSS-TB_1x04-1MP_P1.00mm_Vertical; MPN A1001WR-S; LCSC C160390
J41: Conn_01x02_4PumpHeater B; JST_PH_B2B-PH-K_1x02_P2.00mm_Vertical; LCSC C5175230
J42: Conn_01x02_4PumpHeater A; JST_PH_B2B-PH-K_1x02_P2.00mm_Vertical; LCSC C5175230
J43: JST_SH_Conn_01x04_4K Diode; JST_SH_BM04B-SRSS-TB_1x04-1MP_P1.00mm_Vertical; MPN A1001WR-S; LCSC C160390
J44: Conn_01x02_3PumpHeater B; JST_PH_B2B-PH-K_1x02_P2.00mm_Vertical; LCSC C5175230
J45: Conn_01x02_3PumpHeater A; JST_PH_B2B-PH-K_1x02_P2.00mm_Vertical; LCSC C2683610
J46, J48: Conn_01x02_Extra B; JST_PH_B2B-PH-K_1x02_P2.00mm_Vertical; LCSC C5175230
J47, J49: Conn_01x02_Extra A; JST_PH_B2B-PH-K_1x02_P2.00mm_Vertical; LCSC C5175230

Connections:
GND: J1.2 (D2S), J1.5 (D1S), J1.8 (D0S), J1.11 (CKS), J1.17 (GND), J1.20 (SH), J1.21 (SH), J2.2 (D2S), J2.5 (D1S), J2.8 (D0S), J2.11 (CKS), J2.17 (GND), J2.20 (SH), J3.2 (D2S), J3.5 (D1S), J3.8 (D0S), J3.11 (CKS), J3.17 (GND), J3.20 (SH), J4.2 (D2S), J4.5 (D1S), J4.8 (D0S), J4.11 (CKS), J4.17 (GND), J4.20 (SH), J5.2 (D2S), J5.5 (D1S), J5.8 (D0S), J5.11 (CKS), J5.17 (GND), J5.20 (SH), J6.2 (D2S), J6.5 (D1S), J6.8 (D0S), J6.11 (CKS), J6.17 (GND), J6.20 (SH), J7.2 (D2S), J7.5 (D1S), J7.8 (D0S), J7.11 (CKS), J7.17 (GND), J7.20 (SH), J8.2 (D2S), J8.5 (D1S), J8.8 (D0S), J8.11 (CKS), J8.17 (GND), J8.20 (SH), J9.2 (D2S), J9.5 (D1S), J9.8 (D0S), J9.11 (CKS), J9.17 (GND), J9.20 (SH); also elsewhere on the board
unnamed: J1.10 (CK+), J28.2 (VCC)
unnamed: J1.12 (CK-), J28.3 (SDA)
unnamed: J1.7 (D0+), J26.2 (VCC)
unnamed: J1.9 (D0-), J26.3 (SDA)
unnamed: J1.4 (D1+), J24.2 (VCC)
unnamed: J1.6 (D1-), J24.3 (SDA)
unnamed: J1.1 (D2+), J21.2 (VCC)
unnamed: J1.3 (D2-), J21.3 (SDA)
unnamed: J2.10 (CK+), J39.1
unnamed: J2.12 (CK-), J39.2
unnamed: J2.7 (D0+), J37.1
unnamed: J2.9 (D0-), J37.2
unnamed: J2.4 (D1+), J34.2 (VCC)
unnamed: J2.6 (D1-), J34.3 (SDA)
unnamed: J2.1 (D2+), J31.2 (VCC)
unnamed: J2.3 (D2-), J31.3 (SDA)
unnamed: J3.10 (CK+), J49.1
unnamed: J3.12 (CK-), J49.2
unnamed: J3.7 (D0+), J47.1
unnamed: J3.9 (D0-), J47.2
unnamed: J3.4 (D1+), J45.1
unnamed: J3.6 (D1-), J45.2
unnamed: J3.1 (D2+), J42.1
unnamed: J3.3 (D2-), J42.2
unnamed: J7.6 (D1-), J19.4 (SCL)
unnamed: J7.3 (D2-), J19.3 (SDA)
unnamed: J7.1 (D2+), J19.2 (VCC)
unnamed: J7.4 (D1+), J19.1 (gnd)
unnamed: J4.3 (D2-), J20.3 (SDA)
unnamed: J4.1 (D2+), J20.2 (VCC)
unnamed: J7.12 (CK-), J22.4 (SCL)
unnamed: J7.9 (D0-), J22.3 (SDA)
unnamed: J7.7 (D0+), J22.2 (VCC)
unnamed: J7.10 (CK+), J22.1 (gnd)
unnamed: J4.6 (D1-), J23.3 (SDA)
unnamed: J4.4 (D1+), J23.2 (VCC)
unnamed: J4.9 (D0-), J25.3 (SDA)
unnamed: J4.7 (D0+), J25.2 (VCC)
unnamed: J4.12 (CK-), J27.3 (SDA)
unnamed: J4.10 (CK+), J27.2 (VCC)
unnamed: J8.6 (D1-), J29.4 (SCL)
unnamed: J8.3 (D2-), J29.3 (SDA)
unnamed: J8.1 (D2+), J29.2 (VCC)
unnamed: J8.4 (D1+), J29.1 (gnd)
unnamed: J5.3 (D2-), J30.3 (SDA)
unnamed: J5.1 (D2+), J30.2 (VCC)
unnamed: J8.7 (D0+), J32.1
unnamed: J8.9 (D0-), J32.2
unnamed: J5.6 (D1-), J33.3 (SDA)
unnamed: J5.4 (D1+), J33.2 (VCC)
unnamed: J8.10 (CK+), J35.1
unnamed: J8.12 (CK-), J35.2
unnamed: J5.7 (D0+), J36.1
unnamed: J5.9 (D0-), J36.2
unnamed: J5.10 (CK+), J38.1
unnamed: J5.12 (CK-), J38.2
unnamed: J9.6 (D1-), J40.4 (SCL)
unnamed: J9.3 (D2-), J40.3 (SDA)
unnamed: J9.1 (D2+), J40.2 (VCC)
unnamed: J9.4 (D1+), J40.1 (gnd)
unnamed: J6.1 (D2+), J41.1
unnamed: J6.3 (D2-), J41.2
unnamed: J9.12 (CK-), J43.4 (SCL)
unnamed: J9.9 (D0-), J43.3 (SDA)
unnamed: J9.7 (D0+), J43.2 (VCC)
unnamed: J9.10 (CK+), J43.1 (gnd)
unnamed: J6.4 (D1+), J44.1
unnamed: J6.6 (D1-), J44.2
unnamed: J6.7 (D0+), J46.1
unnamed: J6.9 (D0-), J46.2
unnamed: J6.10 (CK+), J48.1
unnamed: J6.12 (CK-), J48.2

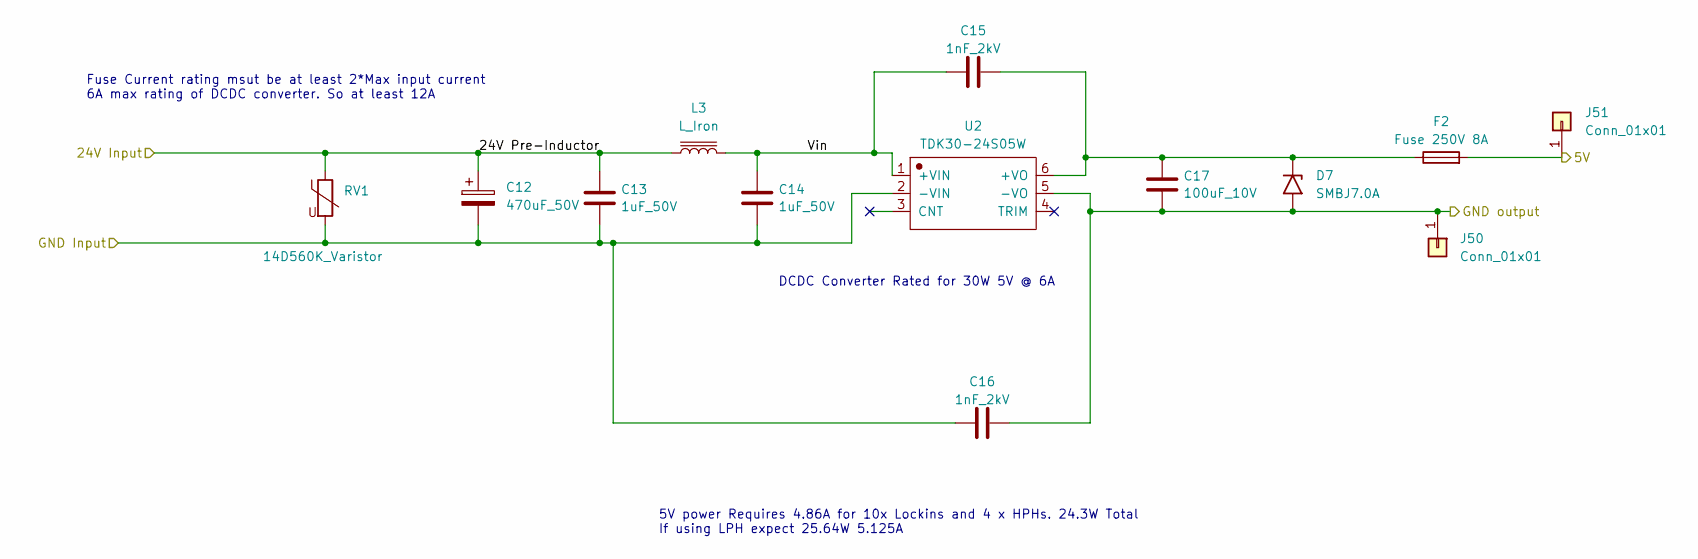
[picture p29: schematic 25V_to5V.kicad_sch.kicad_sch]

Parts:
C12: 470uF_50V; CP_Elec_10x10.5; LCSC C5162365
C13, C14: 1uF_50V; C_0603_1608Metric; LCSC C15849
C15, C16: 1nF_2kV; C_1206_3216Metric; LCSC C9196
C17: 100uF_10V; C_1206_3216Metric; LCSC C9196
D7: SMBJ7.0A; D_SMA; LCSC C693613
F2: Fuse 250V 8A; Fuse_holder; LCSC C268204
J50: Conn_01x01; Test_Point_TH_BD3.2-D2.0; LCSC C5199811
J51: Conn_01x01; Test_Point_TH_BD3.2-D2.0; LCSC C5277086
L3: L_Iron; IND-SMD_L7.1-W6.6; LCSC C439009
RV1: 14D560K_Varistor; RES-TH_L17.0-W5.0-P7.50-D1.2; LCSC C18901
U2: TDK30-24S05W; PWRM-TH_TDK30-XXSXX; LCSC C570789

Connections:
+5V: F2.2, J51.1; also elsewhere on the board
+24V: C12.1, C13.1, L3.1, RV1.1; also elsewhere on the board
/24V to 5V Power/Vin: C14.1, C15.1, L3.2, U2.1 (+VIN)
GND: C16.2, C17.2, D7.2 (A2), J50.1, U2.5 (-VO); also elsewhere on the board
GNDPWR: C12.2, C13.2, C14.2, C16.1, RV1.2, U2.2 (-VIN); also elsewhere on the board
unnamed: C15.2, C17.1, D7.1 (A1), F2.1, U2.6 (+VO)

Notes on the sheet:
DCDC Converter Rated for 30W 5V @ 6A
5V power Requires 4.86A for 10x Lockins and 4 x HPHs. 24.3W Total If using LPH expect 25.64W 5.125A
Fuse Current rating msut be at least 2*Max input current 6A max rating of DCDC converter. So at least 12A

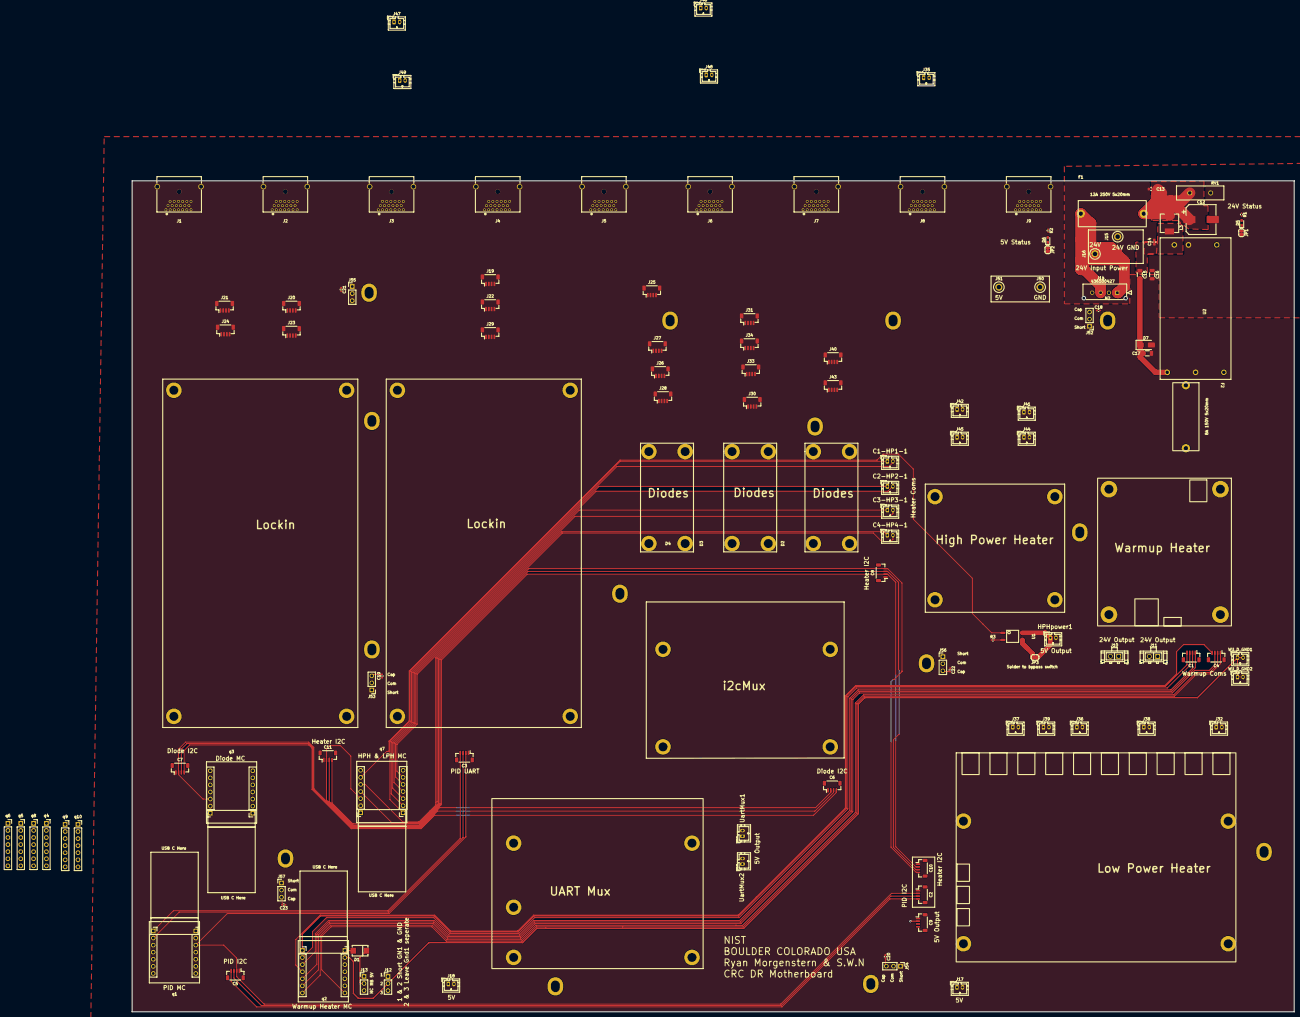
[picture p30: board motherboard_v1.kicad_pcb from above]

Board: 6 copper layers, 417.0 x 298.1 mm, 139 parts (0 on the bottom side), 123 nets.
