morgensternR/Themometry_Enclosure/Thermometry_Enclosure/Thermometry_Enclosure.kicad_pcb

## KiCad design Thermometry_Enclosure/Thermometry_Enclosure.kicad_pcb (2023-06-21)

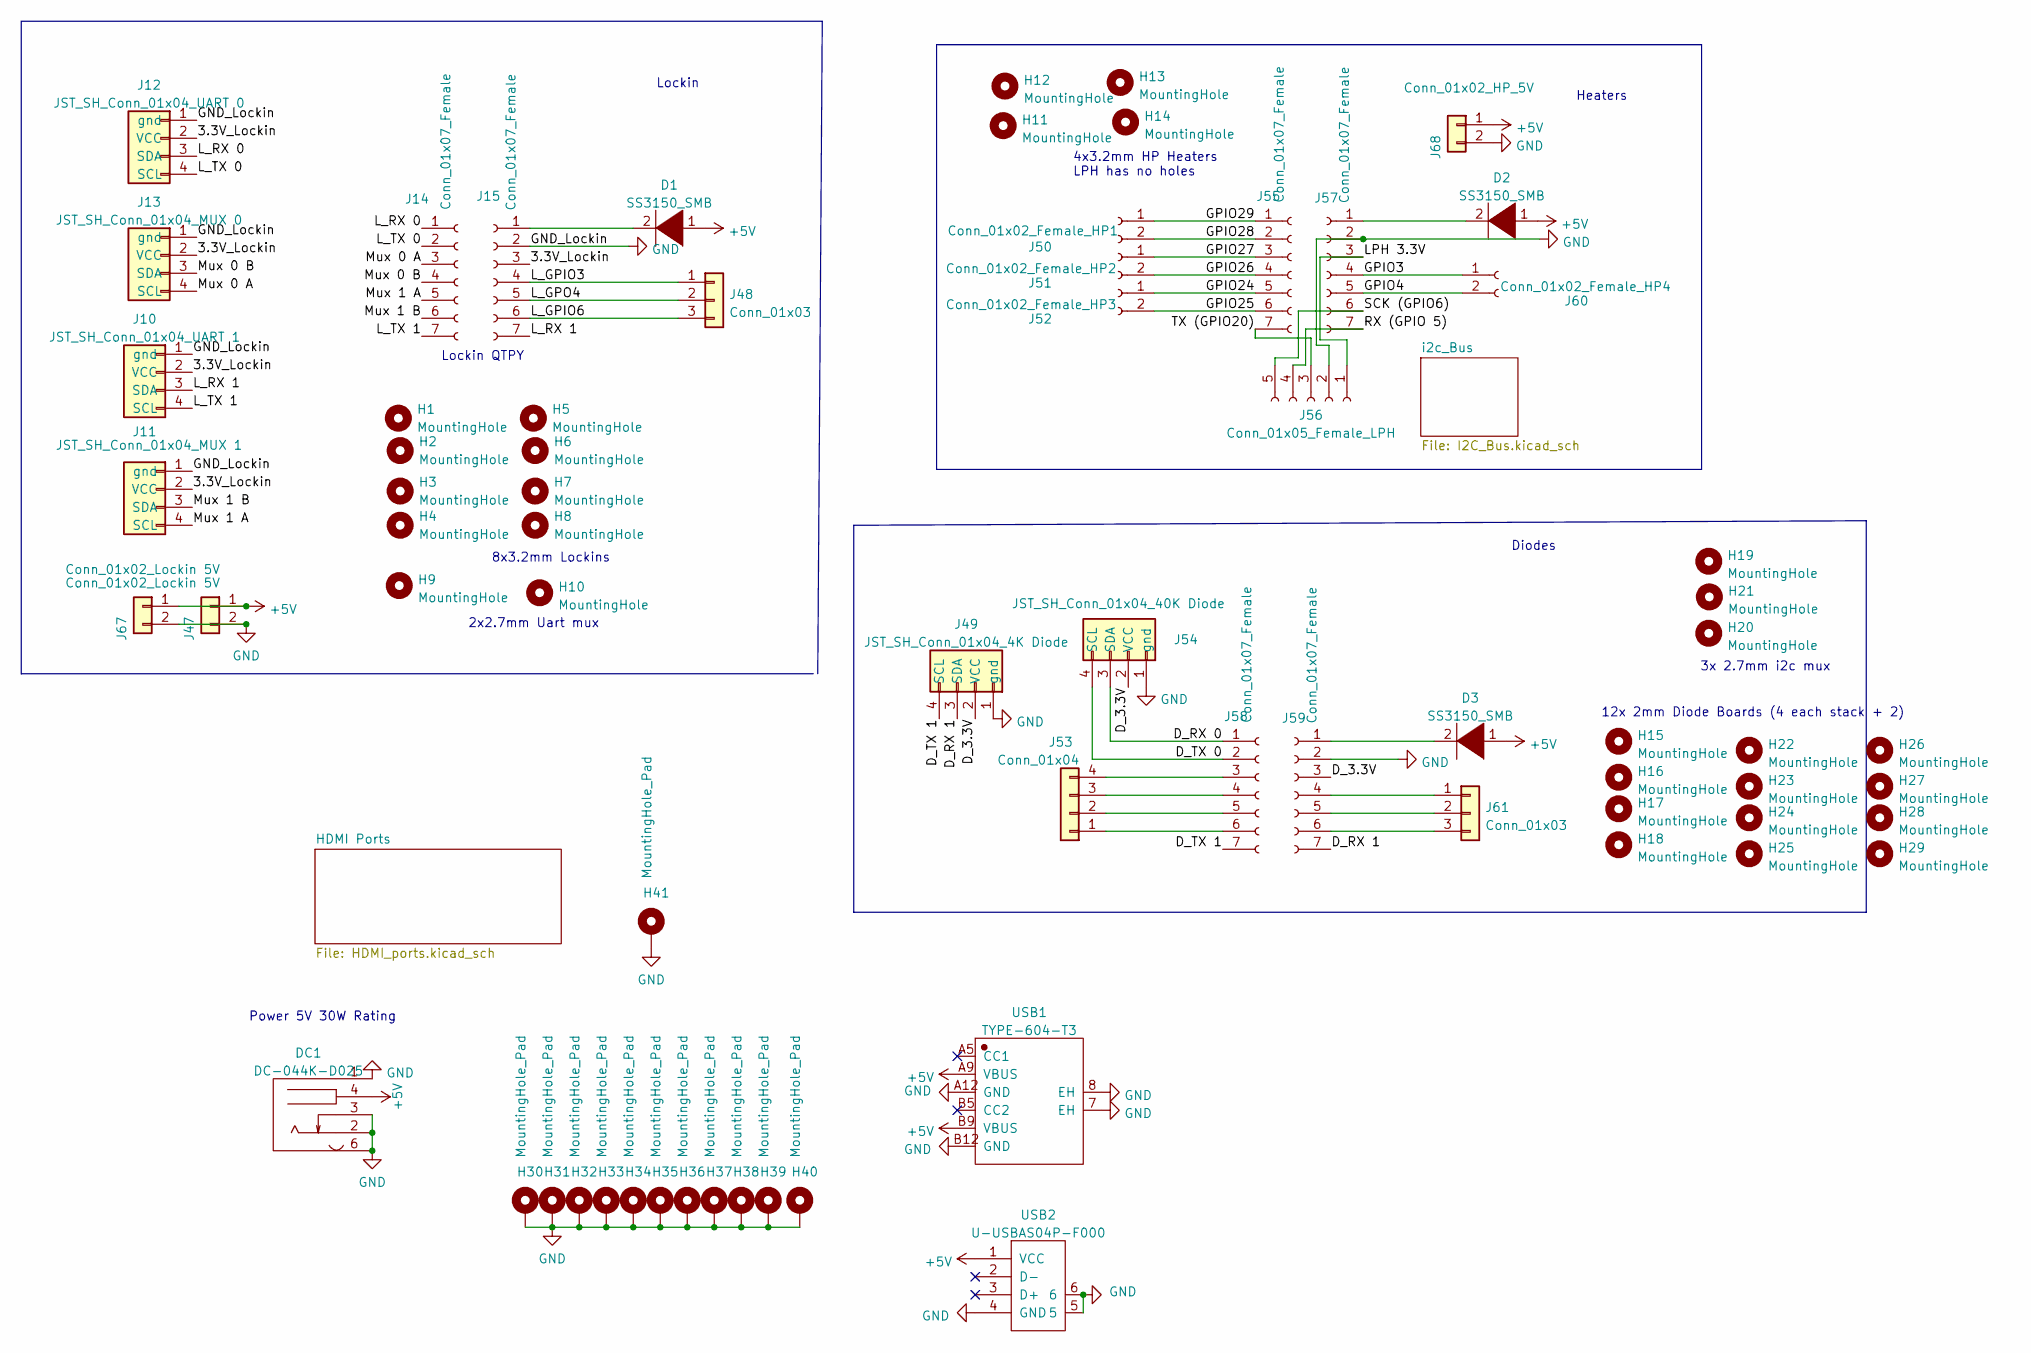
[picture p31: schematic Thermometry_Enclosure.kicad_sch]

Parts:
D1, D2, D3: SS3150_SMB; SMB_L4.6-W3.6-LS5.3-R-RD; LCSC C47124
DC1: DC-044K-D025; DC-IN-TH_DC-044K-D025; LCSC C963204
H1, H2, H3, H4, H5, H6, H7, H8, H11, H12, H13, H14: MountingHole; MountingHole_3.2mm_M3_Pad
H9, H10: MountingHole; MountingHole_2.7mm_Pad
H15, H16, H17, H18, H22, H23, H24, H25, H26, H27, H28, H29: MountingHole; MountingHole_2.2mm_M2_Pad
H19, H20, H21: MountingHole; MountingHole_2.7mm_M2.5_Pad
H30, H31, H32, H33, H34, H35, H36, H37, H38, H39, H40: MountingHole_Pad; MountingHole_5.3mm_M5_Pad
H41: MountingHole_Pad; MountingHole_6.5mm_Pad
J10: JST_SH_Conn_01x04_UART 1; JST_SH_BM04B-SRSS-TB_1x04-1MP_P1.00mm_Vertical; LCSC C160390
J11: JST_SH_Conn_01x04_MUX 1; JST_SH_BM04B-SRSS-TB_1x04-1MP_P1.00mm_Vertical; LCSC C160390
J12: JST_SH_Conn_01x04_UART 0; JST_SH_BM04B-SRSS-TB_1x04-1MP_P1.00mm_Vertical; LCSC C160390
J13: JST_SH_Conn_01x04_MUX 0; JST_SH_BM04B-SRSS-TB_1x04-1MP_P1.00mm_Vertical; LCSC C160390
J14, J15, J55, J57, J58, J59: Conn_01x07_Female; PinSocket_1x07_P2.54mm_Vertical; LCSC C2897370
J47, J67: Conn_01x02_Lockin 5V; JST_PH_B2B-PH-K_1x02_P2.00mm_Vertical; LCSC C2683610
J48, J61: Conn_01x03; PinSocket_1x03_P2.54mm_Vertical
J49: JST_SH_Conn_01x04_4K Diode; JST_SH_BM04B-SRSS-TB_1x04-1MP_P1.00mm_Vertical; LCSC C160390
J50: Conn_01x02_Female_HP1; PinSocket_1x02_P2.54mm_Vertical; LCSC C49661
J51: Conn_01x02_Female_HP2; PinSocket_1x02_P2.54mm_Vertical; LCSC C49661
J52: Conn_01x02_Female_HP3; PinSocket_1x02_P2.54mm_Vertical; LCSC C49661
J53: Conn_01x04; PinSocket_1x04_P2.54mm_Vertical
J54: JST_SH_Conn_01x04_40K Diode; JST_SH_BM04B-SRSS-TB_1x04-1MP_P1.00mm_Vertical; LCSC C160390
J56: Conn_01x05_Female_LPH; PinSocket_1x05_P2.54mm_Vertical; LCSC C50950
J60: Conn_01x02_Female_HP4; PinSocket_1x02_P2.54mm_Vertical; LCSC C49661
J68: Conn_01x02_HP_5V; JST_PH_B2B-PH-K_1x02_P2.00mm_Vertical; LCSC C2683610
USB1: TYPE-604-T3; USB-C-TH_TYPE-604-T3; LCSC C2689839
USB2: U-USBAS04P-F000; USB-A-TH_U-A-24DD-Y-2

Connections:
+5V: D1.1 (K), D2.1 (K), D3.1 (K), DC1.4, J47.1, J67.1, J68.1, USB1.A9 (VBUS), USB1.B9 (VBUS), USB2.1 (VCC)
/3.3V_Lockin: J10.2 (VCC), J11.2 (VCC), J12.2 (VCC), J13.2 (VCC), J15.3
/D_3.3V: J49.2 (VCC), J54.2 (VCC), J59.3
/D_RX 0: J54.3 (SDA), J58.1
/D_RX 1: J49.3 (SDA), J59.7
/D_TX 0: J54.4 (SCL), J58.2
/D_TX 1: J49.4 (SCL), J58.7
/GPIO3: J57.4, J60.1
/GPIO4: J57.5, J60.2
/GPIO24: J52.1, J55.5
/GPIO25: J52.2, J55.6
/GPIO26: J51.2, J55.4
/GPIO27: J51.1, J55.3
/GPIO28: J50.2, J55.2
/GPIO29: J50.1, J55.1
/LPH 3.3V: J56.1, J57.3
/L_GPIO3: J15.4, J48.1
/L_GPIO6: J15.6, J48.3
/L_GPO4: J15.5, J48.2
/L_RX 0: J12.3 (SDA), J14.1
/L_RX 1: J10.3 (SDA), J15.7
/L_TX 0: J12.4 (SCL), J14.2
/L_TX 1: J10.4 (SCL), J14.7
/Mux 0 A: J13.4 (SCL), J14.3
/Mux 0 B: J13.3 (SDA), J14.4
/Mux 1 A: J11.4 (SCL), J14.5
/Mux 1 B: J11.3 (SDA), J14.6
/RX (GPIO 5): J56.4, J57.7
/SCK (GPIO6): J56.5, J57.6
/TX (GPIO20): J55.7, J56.3
GND: DC1.1, DC1.2, DC1.3, DC1.6, H30.1, H31.1, H32.1, H33.1, H34.1, H35.1, H36.1, H37.1, H38.1, H39.1, H40.1, H41.1, J10.1 (gnd), J11.1 (gnd), J12.1 (gnd), J13.1 (gnd), J15.2, J47.2, J49.1 (gnd), J54.1 (gnd), J56.2, J57.2, J59.2, J67.2, J68.2, USB1.7 (EH), USB1.8 (EH), USB1.A12 (GND), USB1.B12 (GND), USB2.4 (GND), USB2.5, USB2.6; also elsewhere on the board
unnamed: D1.2 (A), J15.1
unnamed: D2.2 (A), J57.1
unnamed: D3.2 (A), J59.1
unnamed: J53.1, J58.6
unnamed: J53.2, J58.5
unnamed: J53.3, J58.4
unnamed: J53.4, J58.3
unnamed: J59.4, J61.1
unnamed: J59.5, J61.2
unnamed: J59.6, J61.3

Notes on the sheet:
12x 2mm Diode Boards (4 each stack + 2)
8x3.2mm Lockins
3x 2.7mm i2c mux
Lockin QTPY
Power 5V 30W Rating
2x2.7mm Uart mux
Heaters
Lockin
4x3.2mm HP Heaters LPH has no holes
Diodes
