morgensternR/Themometry_Enclosure/Thermometry_Enclosure/Thermometry_Enclosure.kicad_pcb

## KiCad design Thermometry_Enclosure/Thermometry_Enclosure.kicad_pcb (continued)

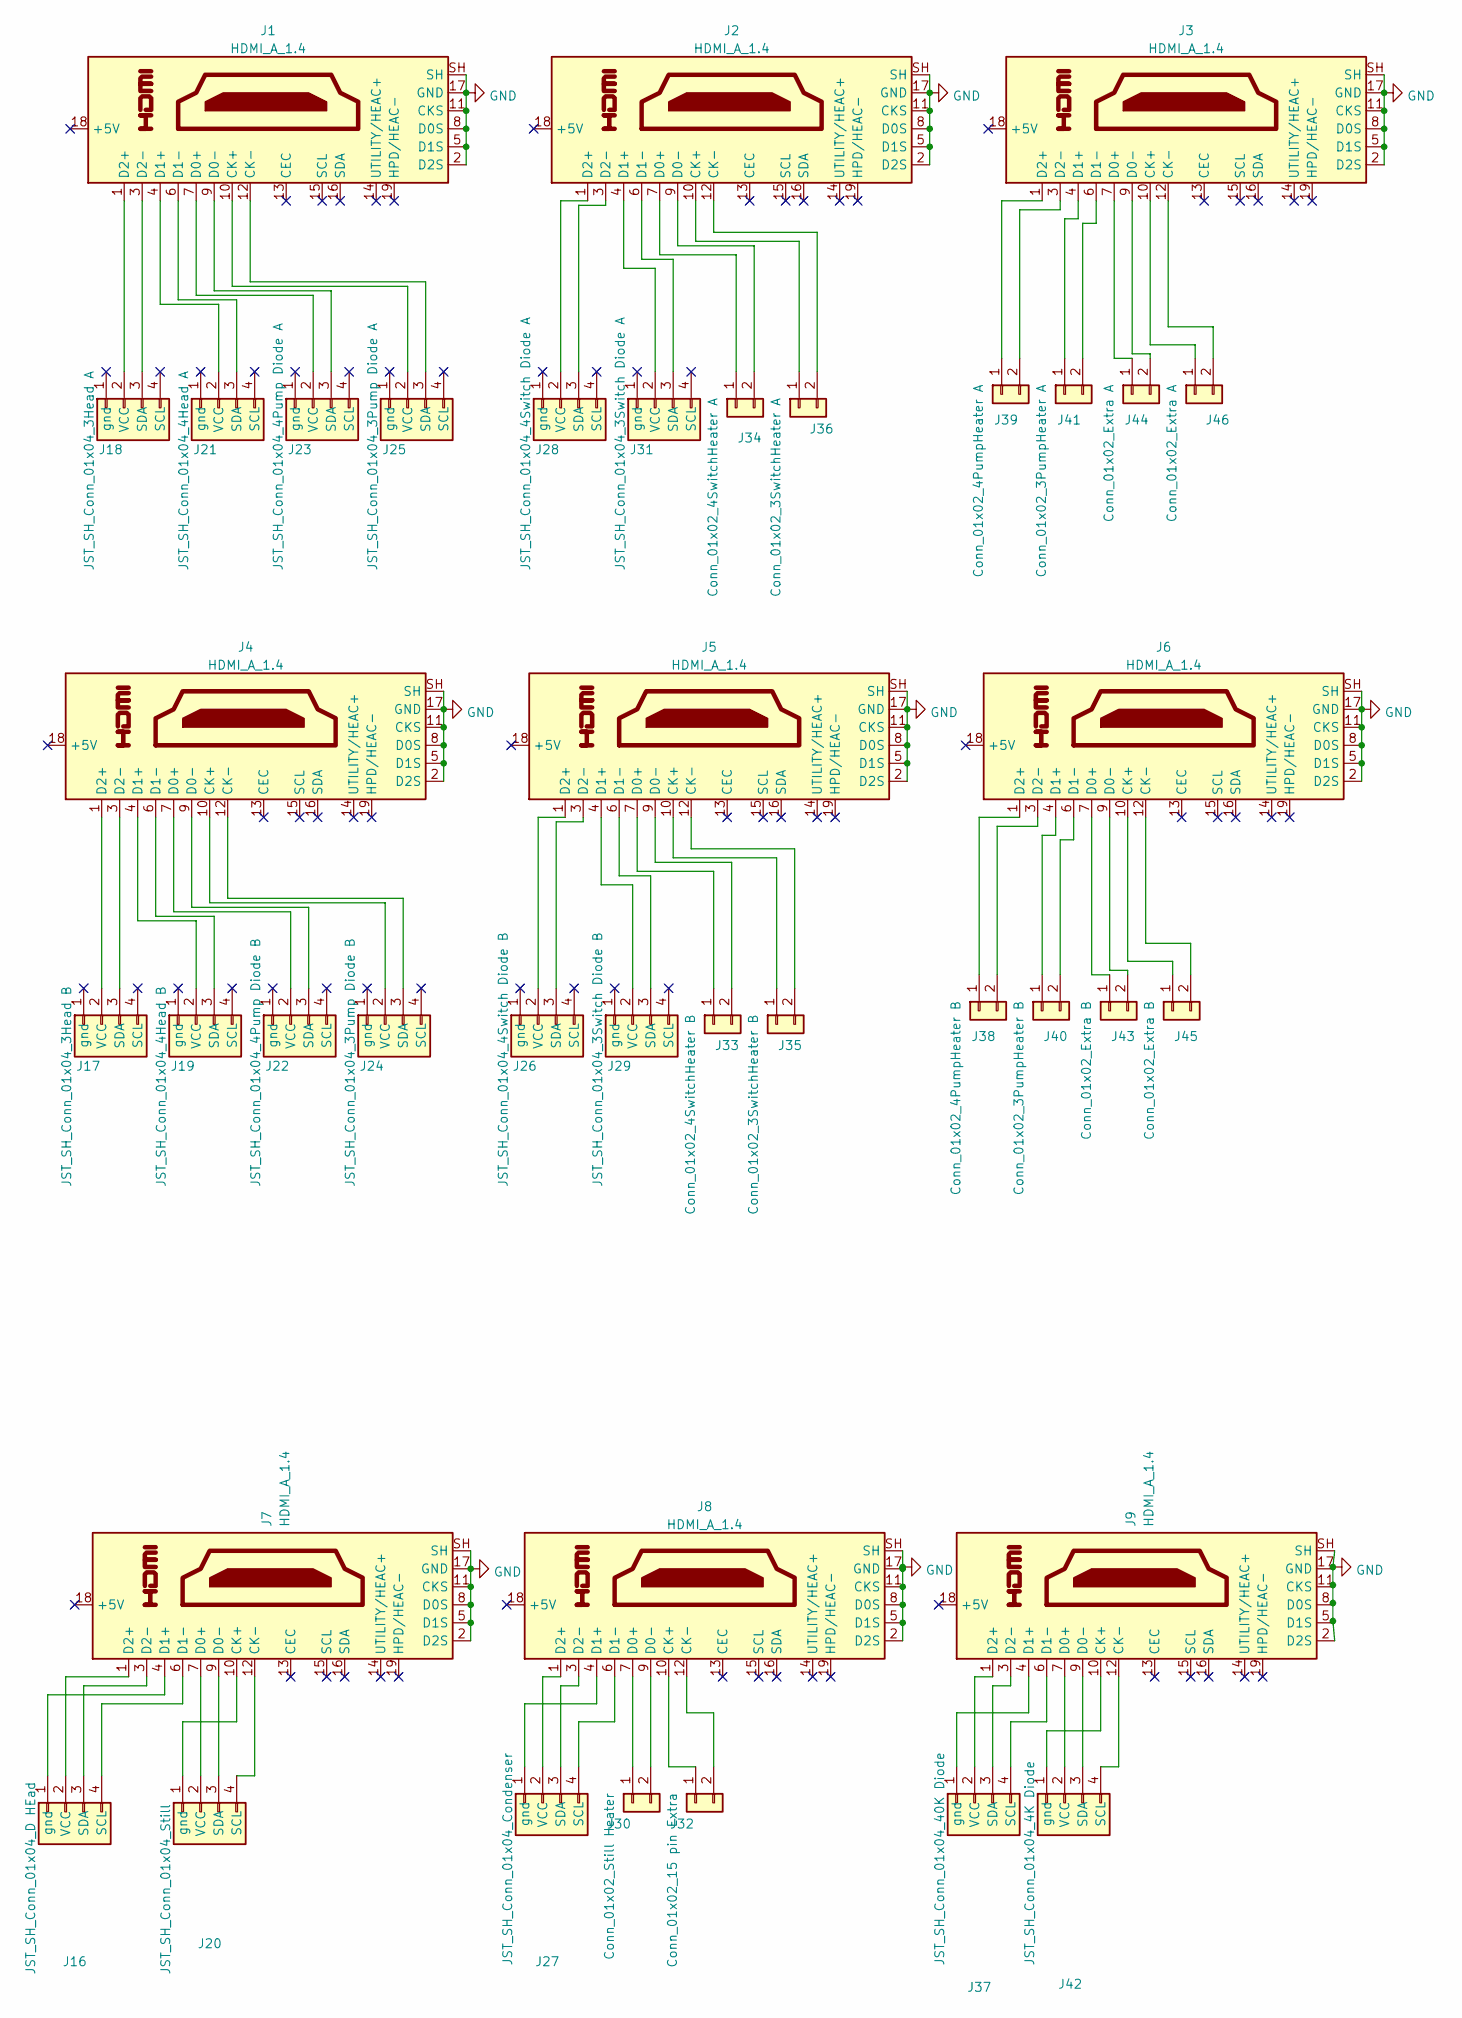
[picture p32: schematic HDMI_ports.kicad_sch]

Parts:
J1, J2, J3, J4, J5, J6, J7, J8, J9: HDMI_A_1.4; HDMI-TH_HYC12-HDMIA19-61; LCSC C711354
J16: JST_SH_Conn_01x04_D HEad; JST_SH_BM04B-SRSS-TB_1x04-1MP_P1.00mm_Vertical; MPN A1001WR-S; LCSC C160390
J17: JST_SH_Conn_01x04_3Head B; JST_SH_BM04B-SRSS-TB_1x04-1MP_P1.00mm_Vertical; MPN A1001WR-S; LCSC C160390
J18: JST_SH_Conn_01x04_3Head A; JST_SH_BM04B-SRSS-TB_1x04-1MP_P1.00mm_Vertical; MPN A1001WR-S; LCSC C160390
J19: JST_SH_Conn_01x04_4Head B; JST_SH_BM04B-SRSS-TB_1x04-1MP_P1.00mm_Vertical; MPN A1001WR-S; LCSC C160390
J20: JST_SH_Conn_01x04_Still; JST_SH_BM04B-SRSS-TB_1x04-1MP_P1.00mm_Vertical; MPN A1001WR-S; LCSC C160390
J21: JST_SH_Conn_01x04_4Head A; JST_SH_BM04B-SRSS-TB_1x04-1MP_P1.00mm_Vertical; MPN A1001WR-S; LCSC C160390
J22: JST_SH_Conn_01x04_4Pump Diode B; JST_SH_BM04B-SRSS-TB_1x04-1MP_P1.00mm_Vertical; MPN A1001WR-S; LCSC C160390
J23: JST_SH_Conn_01x04_4Pump Diode A; JST_SH_BM04B-SRSS-TB_1x04-1MP_P1.00mm_Vertical; MPN A1001WR-S; LCSC C160390
J24: JST_SH_Conn_01x04_3Pump Diode B; JST_SH_BM04B-SRSS-TB_1x04-1MP_P1.00mm_Vertical; MPN A1001WR-S; LCSC C160390
J25: JST_SH_Conn_01x04_3Pump Diode A; JST_SH_BM04B-SRSS-TB_1x04-1MP_P1.00mm_Vertical; MPN A1001WR-S; LCSC C160390
J26: JST_SH_Conn_01x04_4Switch Diode B; JST_SH_BM04B-SRSS-TB_1x04-1MP_P1.00mm_Vertical; MPN A1001WR-S; LCSC C160390
J27: JST_SH_Conn_01x04_Condenser; JST_SH_BM04B-SRSS-TB_1x04-1MP_P1.00mm_Vertical; MPN A1001WR-S; LCSC C160390
J28: JST_SH_Conn_01x04_4Switch Diode A; JST_SH_BM04B-SRSS-TB_1x04-1MP_P1.00mm_Vertical; MPN A1001WR-S; LCSC C160390
J29: JST_SH_Conn_01x04_3Switch Diode B; JST_SH_BM04B-SRSS-TB_1x04-1MP_P1.00mm_Vertical; MPN A1001WR-S; LCSC C160390
J30: Conn_01x02_Still Heater; JST_PH_B2B-PH-K_1x02_P2.00mm_Vertical; LCSC C2683610
J31: JST_SH_Conn_01x04_3Switch Diode A; JST_SH_BM04B-SRSS-TB_1x04-1MP_P1.00mm_Vertical; MPN A1001WR-S; LCSC C160390
J32: Conn_01x02_15 pin Extra; JST_PH_B2B-PH-K_1x02_P2.00mm_Vertical; LCSC C2683610
J33: Conn_01x02_4SwitchHeater B; JST_PH_B2B-PH-K_1x02_P2.00mm_Vertical; LCSC C2683610
J34: Conn_01x02_4SwitchHeater A; JST_PH_B2B-PH-K_1x02_P2.00mm_Vertical; LCSC C2683610
J35: Conn_01x02_3SwitchHeater B; JST_PH_B2B-PH-K_1x02_P2.00mm_Vertical; LCSC C2683610
J36: Conn_01x02_3SwitchHeater A; JST_PH_B2B-PH-K_1x02_P2.00mm_Vertical; LCSC C2683610
J37: JST_SH_Conn_01x04_40K Diode; JST_SH_BM04B-SRSS-TB_1x04-1MP_P1.00mm_Vertical; MPN A1001WR-S; LCSC C160390
J38: Conn_01x02_4PumpHeater B; JST_PH_B2B-PH-K_1x02_P2.00mm_Vertical; LCSC C2683610
J39: Conn_01x02_4PumpHeater A; JST_PH_B2B-PH-K_1x02_P2.00mm_Vertical; LCSC C2683610
J40: Conn_01x02_3PumpHeater B; JST_PH_B2B-PH-K_1x02_P2.00mm_Vertical; LCSC C2683610
J41: Conn_01x02_3PumpHeater A; JST_PH_B2B-PH-K_1x02_P2.00mm_Vertical; LCSC C2683610
J42: JST_SH_Conn_01x04_4K Diode; JST_SH_BM04B-SRSS-TB_1x04-1MP_P1.00mm_Vertical; MPN A1001WR-S; LCSC C160390
J43, J45: Conn_01x02_Extra B; JST_PH_B2B-PH-K_1x02_P2.00mm_Vertical; LCSC C2683610
J44, J46: Conn_01x02_Extra A; JST_PH_B2B-PH-K_1x02_P2.00mm_Vertical; LCSC C2683610

Connections:
GND: J1.2 (D2S), J1.5 (D1S), J1.8 (D0S), J1.11 (CKS), J1.17 (GND), J1.SH, J2.2 (D2S), J2.5 (D1S), J2.8 (D0S), J2.11 (CKS), J2.17 (GND), J2.SH, J3.2 (D2S), J3.5 (D1S), J3.8 (D0S), J3.11 (CKS), J3.17 (GND), J3.SH, J4.2 (D2S), J4.5 (D1S), J4.8 (D0S), J4.11 (CKS), J4.17 (GND), J4.SH, J5.2 (D2S), J5.5 (D1S), J5.8 (D0S), J5.11 (CKS), J5.17 (GND), J5.SH, J6.2 (D2S), J6.5 (D1S), J6.8 (D0S), J6.11 (CKS), J6.17 (GND), J6.SH, J7.2 (D2S), J7.5 (D1S), J7.8 (D0S), J7.11 (CKS), J7.17 (GND), J7.SH, J8.2 (D2S), J8.5 (D1S), J8.8 (D0S), J8.11 (CKS), J8.17 (GND), J8.SH, J9.2 (D2S), J9.5 (D1S), J9.8 (D0S), J9.11 (CKS), J9.17 (GND), J9.SH; also elsewhere on the board
unnamed: J1.1 (D2+), J18.2 (VCC)
unnamed: J1.3 (D2-), J18.3 (SDA)
unnamed: J1.4 (D1+), J21.2 (VCC)
unnamed: J1.6 (D1-), J21.3 (SDA)
unnamed: J1.7 (D0+), J23.2 (VCC)
unnamed: J1.9 (D0-), J23.3 (SDA)
unnamed: J1.10 (CK+), J25.2 (VCC)
unnamed: J1.12 (CK-), J25.3 (SDA)
unnamed: J2.1 (D2+), J28.2 (VCC)
unnamed: J2.3 (D2-), J28.3 (SDA)
unnamed: J2.4 (D1+), J31.2 (VCC)
unnamed: J2.6 (D1-), J31.3 (SDA)
unnamed: J2.7 (D0+), J34.1
unnamed: J2.9 (D0-), J34.2
unnamed: J2.10 (CK+), J36.1
unnamed: J2.12 (CK-), J36.2
unnamed: J3.1 (D2+), J39.1
unnamed: J3.3 (D2-), J39.2
unnamed: J3.4 (D1+), J41.1
unnamed: J3.6 (D1-), J41.2
unnamed: J3.7 (D0+), J44.1
unnamed: J3.9 (D0-), J44.2
unnamed: J3.10 (CK+), J46.1
unnamed: J3.12 (CK-), J46.2
unnamed: J7.4 (D1+), J16.1 (gnd)
unnamed: J7.1 (D2+), J16.2 (VCC)
unnamed: J7.3 (D2-), J16.3 (SDA)
unnamed: J7.6 (D1-), J16.4 (SCL)
unnamed: J4.1 (D2+), J17.2 (VCC)
unnamed: J4.3 (D2-), J17.3 (SDA)
unnamed: J4.4 (D1+), J19.2 (VCC)
unnamed: J4.6 (D1-), J19.3 (SDA)
unnamed: J7.10 (CK+), J20.1 (gnd)
unnamed: J7.7 (D0+), J20.2 (VCC)
unnamed: J7.9 (D0-), J20.3 (SDA)
unnamed: J7.12 (CK-), J20.4 (SCL)
unnamed: J4.7 (D0+), J22.2 (VCC)
unnamed: J4.9 (D0-), J22.3 (SDA)
unnamed: J4.10 (CK+), J24.2 (VCC)
unnamed: J4.12 (CK-), J24.3 (SDA)
unnamed: J5.1 (D2+), J26.2 (VCC)
unnamed: J5.3 (D2-), J26.3 (SDA)
unnamed: J8.4 (D1+), J27.1 (gnd)
unnamed: J8.1 (D2+), J27.2 (VCC)
unnamed: J8.3 (D2-), J27.3 (SDA)
unnamed: J8.6 (D1-), J27.4 (SCL)
unnamed: J5.4 (D1+), J29.2 (VCC)
unnamed: J5.6 (D1-), J29.3 (SDA)
unnamed: J8.7 (D0+), J30.1
unnamed: J8.9 (D0-), J30.2
unnamed: J8.10 (CK+), J32.1
unnamed: J8.12 (CK-), J32.2
unnamed: J5.7 (D0+), J33.1
unnamed: J5.9 (D0-), J33.2
unnamed: J5.10 (CK+), J35.1
unnamed: J5.12 (CK-), J35.2
unnamed: J9.4 (D1+), J37.1 (gnd)
unnamed: J9.1 (D2+), J37.2 (VCC)
unnamed: J9.3 (D2-), J37.3 (SDA)
unnamed: J9.6 (D1-), J37.4 (SCL)
unnamed: J6.1 (D2+), J38.1
unnamed: J6.3 (D2-), J38.2
unnamed: J6.4 (D1+), J40.1
unnamed: J6.6 (D1-), J40.2
unnamed: J9.10 (CK+), J42.1 (gnd)
unnamed: J9.7 (D0+), J42.2 (VCC)
unnamed: J9.9 (D0-), J42.3 (SDA)
unnamed: J9.12 (CK-), J42.4 (SCL)
unnamed: J6.7 (D0+), J43.1
unnamed: J6.9 (D0-), J43.2
unnamed: J6.10 (CK+), J45.1
unnamed: J6.12 (CK-), J45.2

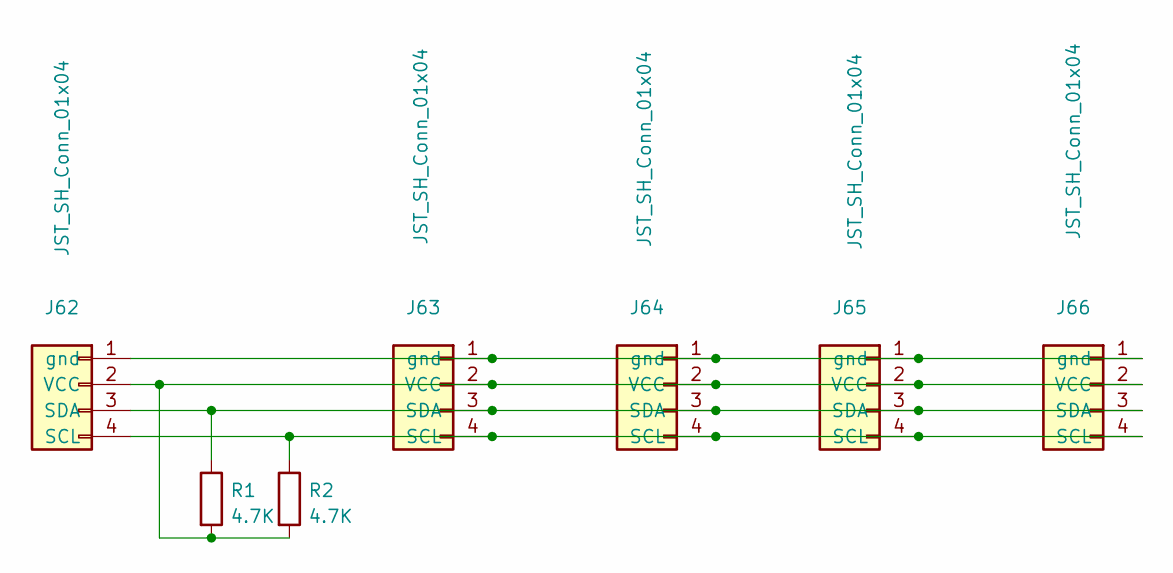
[picture p33: schematic I2C_Bus.kicad_sch]

Parts:
J62, J63, J64, J65, J66: JST_SH_Conn_01x04; JST_SH_BM04B-SRSS-TB_1x04-1MP_P1.00mm_Vertical; LCSC C160390
R1, R2: 4.7K; R_0603_1608Metric_Pad0.98x0.95mm_HandSolder; LCSC C99782

Connections:
unnamed: J62.1 (gnd), J63.1 (gnd), J64.1 (gnd), J65.1 (gnd), J66.1 (gnd)
unnamed: J62.2 (VCC), J63.2 (VCC), J64.2 (VCC), J65.2 (VCC), J66.2 (VCC), R1.2, R2.2
unnamed: J62.3 (SDA), J63.3 (SDA), J64.3 (SDA), J65.3 (SDA), J66.3 (SDA), R1.1
unnamed: J62.4 (SCL), J63.4 (SCL), J64.4 (SCL), J65.4 (SCL), J66.4 (SCL), R2.1

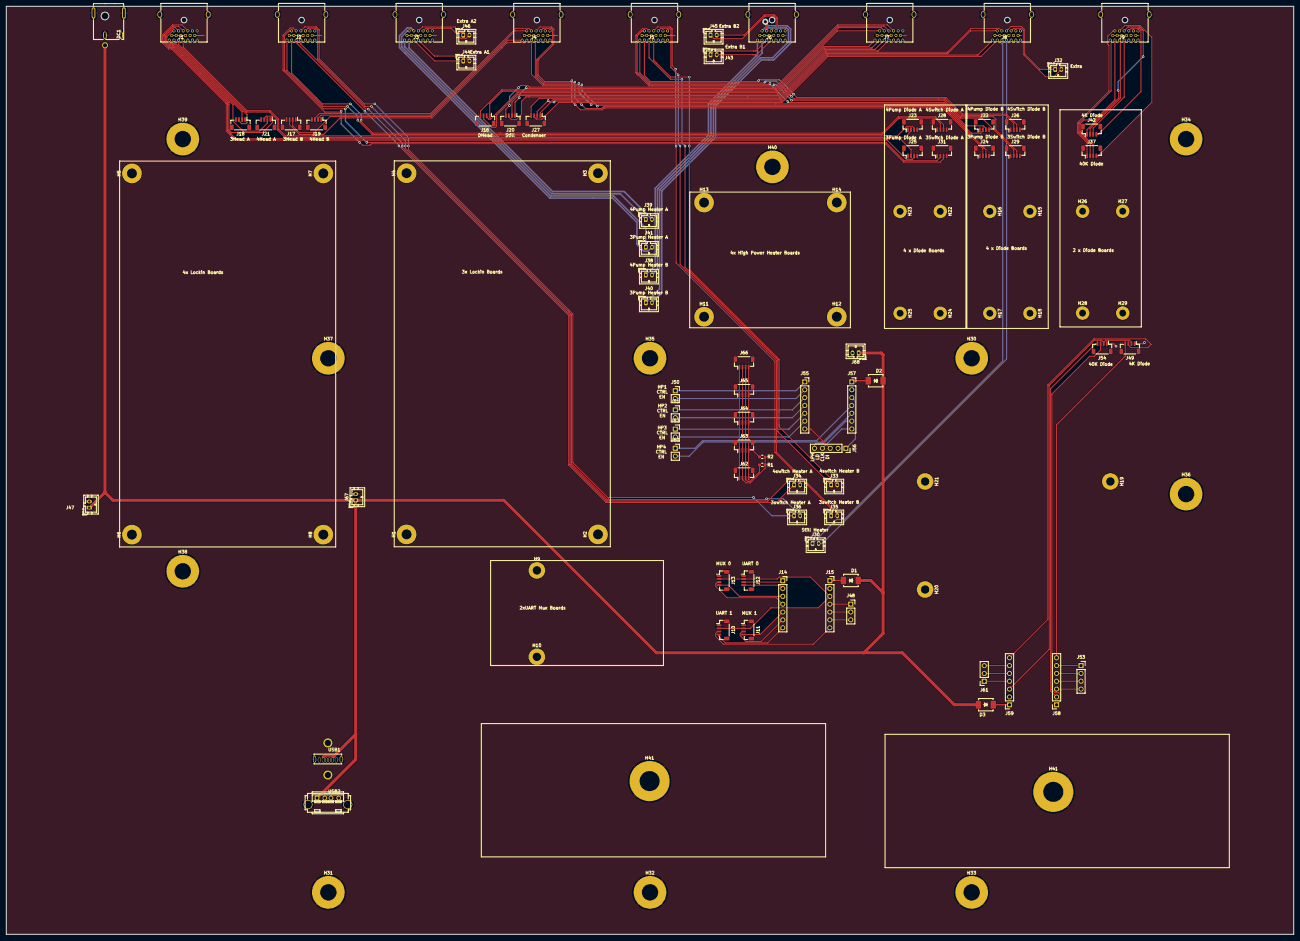
[picture p34: board Thermometry_Enclosure.kicad_pcb from above]

Board: 2 copper layers, 417.0 x 300.6 mm, 118 parts (0 on the bottom side), 117 nets.

Other parts of the board:
H41#2: MountingHole_Pad; MountingHole_6.5mm_Pad

Their connections:
GND: H41#2.1; also elsewhere on the board
